moreyrajulian/arquitectura_de_computadoras/docs/spec/pipeline.md

# Arquitectura del pipeline y camino de datos

Este documento fija **qué hace cada etapa** del procesador y **qué información viaja
entre ellas**, para poder codificar `rtl/pipeline/` sin dudas sobre las interfaces.
Las instrucciones soportadas y su codificación están en [`isa.md`](isa.md).

---

## 1. Visión general

Procesador RV32I (subset de la consigna + HALT) segmentado en 5 etapas. Todo el diseño
corre en **un único dominio de reloj**: el clock nunca se detiene; parar o avanzar el
core se hace con señales de *enable* (ver `docs/diagramas/sistema.png`).

| Etapa | Qué hace | Bloques principales |
|---|---|---|
| **IF** | Mantiene el PC y lee la instrucción | registro PC, sumador `+4`, mux de próximo PC, memoria de programa |
| **ID** | Decodifica, lee registros, arma el inmediato y el control | banco de registros, generador de inmediatos, unidad de control |
| **EX** | Opera y calcula direcciones y destinos de salto | ALU, muxes de operandos, sumador de destino¹ |
| **MEM** | Lee o escribe la memoria de datos | memoria de datos, alineación y máscara de bytes |
| **WB** | Elige el valor final y lo escribe en `rd` | extensión de loads, mux de write-back |

¹ Los saltos se resuelven en EX, sin predicción (decisión [012](../decisiones/012_resolucion-saltos.md)).

```
        ┌────┐  IF/ID  ┌────┐  ID/EX  ┌────┐  EX/MEM  ┌─────┐  MEM/WB  ┌────┐
 PC ──► │ IF │ ──██──► │ ID │ ──██──► │ EX │ ──██───► │ MEM │ ──██───► │ WB │
        └────┘         └────┘         └────┘          └─────┘          └────┘
                          ▲                                               │
                          └──────────── escritura de rd ◄─────────────────┘
```

Los bloques `██` son los **registros de segmentación** (los "latches intermedios" de la
consigna): guardan todo lo que una instrucción necesita para las etapas siguientes
mientras pasa de una etapa a otra.

El camino de datos completo, con todos los bloques, campos y señales de control de este
documento, está en [`docs/diagramas/datapath.png`](../diagramas/datapath.png) (fuente
editable: `datapath.drawio`):

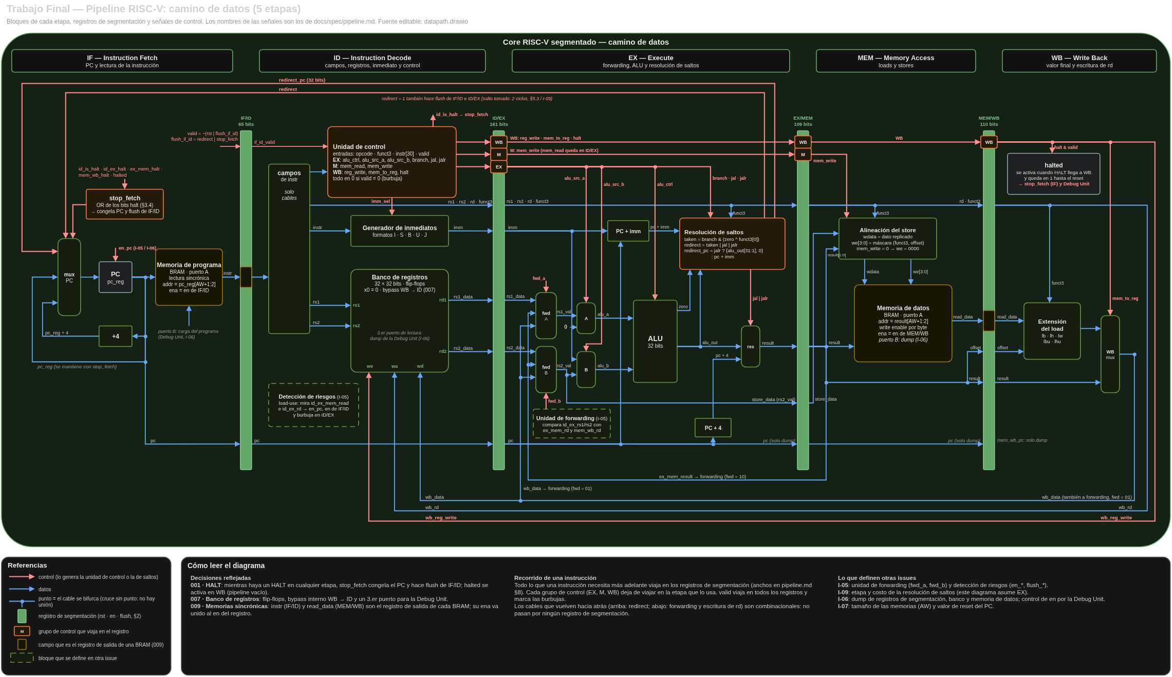
[picture p2: docs/diagramas/datapath.png]
Camino de datos del pipeline


Cómo se detectan y resuelven los riesgos de datos y de control (forwarding, stall y flush)
está en la §10, con su diagrama
[`docs/diagramas/control_riesgos.png`](../diagramas/control_riesgos.png).

---

## 2. Convenciones

### Anchos
Datos y direcciones de **32 bits**. Números de registro de 5 bits (`x0`–`x31`).

### Nombres
- Señal interna de una etapa: prefijo de la etapa (`if_`, `id_`, `ex_`, `mem_`, `wb_`).
- Campo de un registro de segmentación: prefijo del registro (`if_id_`, `id_ex_`,
  `ex_mem_`, `mem_wb_`). Ejemplo: `id_ex_rs1_data` es el valor de `rs1` que ID dejó
  guardado para EX.
- Puertos de módulo: `i_` / `o_`.

### Control de los registros de segmentación
Todos tienen las mismas tres entradas:

| Entrada | Efecto |
|---|---|
| `rst` | Carga una burbuja. |
| `en` | En 0 conserva el contenido (stall o core detenido por la Debug Unit). |
| `flush` | En 1 carga una burbuja en lugar de la instrucción entrante. |

Prioridad: `rst` > `en` > `flush`. Con `en = 0` el registro conserva su contenido aunque
`flush` valga 1: un stall o el core detenido nunca pierden la instrucción retenida.

Quién maneja `en` y `flush` está en §10.4: `en` lo bajan la detección de riesgos (stall) y la
Debug Unit (`enable`, I-06); `flush` lo generan la resolución de saltos y la detección de
riesgos, nunca la Debug Unit.

### Burbujas y bit `valid`
Cada registro de segmentación lleva un bit `valid` que indica si contiene una
instrucción real. Una **burbuja** es un registro con `valid = 0` y todas las señales de
control con efectos en 0 (escritura de registro, escritura de memoria, salto y halt); sus
campos de datos no importan.

El bit `valid` permite que el dump muestre qué etapas están vacías, que "pipeline
vacío" se pueda verificar (todos los `valid` en 0) y que se pueda anular la instrucción
de IF/ID (§3.3).

---

## 3. Etapa IF — Instruction Fetch

**Qué hace:** mantiene el PC, lee la instrucción que está en esa dirección y decide cuál
es el próximo PC.

```mermaid
flowchart LR
    MUX["mux de próximo PC"] --> PC["pc_reg"]
    PC --> SUM["+4"]
    SUM --> MUX
    SALTO["redirect / redirect_pc<br/>(etapa de salto)"] --> MUX
    PC --> IMEM["memoria de programa<br/>BRAM, puerto A"]
    IMEM -- "instr" --> IFID[["IF/ID"]]
    PC -- "pc" --> IFID
```

### 3.1 Próximo PC

```
si   redirect      →  pc_next = redirect_pc      (salto tomado: gana siempre)
sino stop_fetch    →  pc_next = pc_reg           (HALT en vuelo, §3.4)
sino               →  pc_next = pc_reg + 4
pc_reg <= pc_next     solo si en_pc = 1
```

| Señal | Ancho | Viene de | Significado |
|---|---|---|---|
| `redirect` | 1 | EX: resolución de saltos (§5.3) | Hay que cambiar el flujo: `beq`/`bne` tomado, `jal` o `jalr`. |
| `redirect_pc` | 32 | EX: resolución de saltos (§5.3) | Destino ya calculado: `PC + imm` o `(rs1 + imm) & ~1`. |
| `stop_fetch` | 1 | §3.4 | Hay un HALT en el pipeline. Congela el PC y, a través de `flush_if_id` (§3.3), invalida lo que entra a IF/ID. |
| `en_pc` | 1 | §10.4 | En 0 el PC no avanza (stall o core detenido). |

IF no necesita saber qué tipo de salto hubo: recibe la dirección ya calculada.
Valor de reset del PC: `0x0000_0000`, la primera palabra de la memoria de programa
([`memoria.md`](memoria.md) §2).

### 3.2 Memoria de programa
BRAM de lectura sincrónica: **entrega el dato un ciclo después** de recibir la dirección.
Tiene 1024 palabras (`IMEM_AW = 10`, [`memoria.md`](memoria.md)). Se direcciona con
`pc_reg[IMEM_AW+1:2]` (las instrucciones están alineadas a 4 bytes) y **su
registro de salida hace de campo `instr` de IF/ID**, así que no se agrega ningún ciclo
(decisión [009](../decisiones/009_memorias-sincronicas.md)):

```
ciclo          t            t+1           t+2
pc_reg         p            p+4           p+8
dout BRAM      (anterior)   instr(p)      instr(p+4)
if_id_pc       (anterior)   p             p+4
etapa ID       —            instr(p)      instr(p+4)
```

### 3.3 Stall, flush y reset
- **Stall:** el `ena` de la BRAM va unido al `en` de IF/ID. Con `ena = 0` la salida no
  cambia y la instrucción queda quieta.
- **Flush:** la salida de la BRAM no se puede borrar, así que el flush pone
  `if_id_valid = 0`. ID ve `valid = 0` y trata la instrucción como burbuja (§4.4).
  IF/ID tiene dos motivos de flush: un salto tomado (`redirect`) y una parada por HALT
  (`stop_fetch`, §3.4).
- **Reset:** pone `if_id_valid = 0`. La basura que tiene la BRAM a la salida después de un
  reset se ignora con el mismo mecanismo.
- **Stall y salto a la vez:** si en el mismo ciclo hay un stall (§10.3) y `redirect = 1`,
  gana el salto: el stall se anula (`en = 1`), la instrucción que quería retener está en el
  camino equivocado y se descarta con el flush, y el PC toma `redirect_pc`.

En resumen:

```
flush_if_id  = redirect | stop_fetch
if_id_valid <= ~(rst | flush_if_id)          (en cada flanco con en = 1; con en = 0 no cambia)
```

### 3.4 Parada por HALT
Mientras haya un HALT en el pipeline, IF deja de buscar instrucciones. Así detrás del HALT
solo entran burbujas, y cuando llega a WB el pipeline queda vacío
(decisión [001](../decisiones/001_instruccion-halt.md)).

```
stop_fetch  = id_is_halt | id_ex_halt | ex_mem_halt | mem_wb_halt | halted
```

`stop_fetch` actúa en dos lugares, y hacen falta los dos:

1. **PC** (§3.1): `pc_next = pc_reg`, así que no se buscan instrucciones nuevas.
2. **IF/ID** (§3.3): `flush_if_id = 1`, así que lo que entra a IF/ID es burbuja.

El primero solo no alcanza. En el ciclo en que el HALT está en ID, `pc_reg` ya vale
`h + 4` (h = dirección del HALT) y la BRAM ya está leyendo esa dirección: esa instrucción
aparece en `if_id_instr` en el flanco siguiente y no se puede cancelar. Además, con el PC
congelado, la BRAM vuelve a leer `h + 4` en cada ciclo. Sin el flush, esa instrucción
entraría como válida y se repetiría ciclo tras ciclo.

```
ciclo              t            t+1          t+2          t+3          t+4
HALT en            IF           ID           EX           MEM          WB → halted <= 1
pc_reg             h            h+4          h+4          h+4          h+4
BRAM lee           h            h+4          h+4          h+4          h+4
stop_fetch         0            1            1            1            1
IF/ID recibe       HALT (1)     h+4 (0)      h+4 (0)      h+4 (0)      h+4 (0)
```

(El número entre paréntesis es el `valid` que se guarda en IF/ID en el flanco del final
de ese ciclo.)

La parada mira el bit `halt` de todas las etapas porque el HALT está en ID un solo ciclo:
si se mirara solo ID, en t+2 el PC volvería a avanzar y entrarían instrucciones posteriores
al HALT. Al terminar t+4, `halted = 1` mantiene la parada.

- **HALT en el camino equivocado:** si un salto anterior se toma, `redirect` gana en el
  mux del PC (§3.1) y el flush convierte al HALT en burbuja. Su bit `halt` desaparece y
  `stop_fetch` se apaga solo, sin lógica extra.
- **HALT retenido por un stall:** la palabra del HALT (`0x0010_0073`) tiene `1` en el campo
  `rs2` (es el inmediato de `ebreak`), así que un load a `x1` justo antes puede disparar la
  detección de load-use (§10.3). Como `en` tiene prioridad sobre `flush` (§2), IF/ID conserva
  el HALT durante el stall y no se pierde.
- **Programa sin HALT:** `stop_fetch` no se activa nunca y el PC sigue avanzando. En la
  práctica no pasa, porque `LOAD` rellena con HALT lo que el programa no ocupa. Solo un
  programa de 1024 palabras sin HALT llega a `0x1000`, vuelve a `imem[0]` por el alias y
  levanta `imem_fault` ([`memoria.md`](memoria.md) §6.1, decisiones 001 y
  [015](../decisiones/015_accesos-desalineados-y-fuera-de-rango.md)). Un bucle infinito
  tampoco termina: para eso está `STOP` ([`protocolo_debug.md`](protocolo_debug.md) §3.5).

**En el RTL** (I-37), `stop_fetch` se calcula en `riscv_core` y entra a `pc_logic` y a
`hazard_unit`, que desde I-42 calcula los enables y el flush de §10.4. Ningún término necesita
combinarse con `valid`: `id_is_halt` sale de `id_stage` ya anulado en una burbuja (la unidad
de control da todo en 0, §4.4), y una burbuja lleva `halt = 0` en ID/EX, EX/MEM y MEM/WB (§2). Con el PC congelado, después de la parada
`pc_reg` vale `h + 4`, que es el PC que ve la Debug Unit en el bloque de estado.

### 3.5 Salidas hacia IF/ID

| Campo | Ancho | Descripción |
|---|---|---|
| `if_id_pc` | 32 | PC de la instrucción. |
| `if_id_instr` | 32 | Instrucción (salida registrada de la BRAM). |
| `if_id_valid` | 1 | 1 = instrucción real, 0 = burbuja. |

`PC + 4` no viaja: se recalcula en EX cuando hace falta (`jal`, `jalr`).

---

## 4. Etapa ID — Instruction Decode

**Qué hace:** convierte los 32 bits de la instrucción en todo lo que las etapas
siguientes necesitan para ejecutarla: los **valores** de los registros fuente, el
**inmediato** y las **señales de control**. Toda la lógica es combinacional; el resultado
se guarda en ID/EX al final del ciclo.

```mermaid
flowchart LR
    IFID[["IF/ID"]] -- "instr" --> CAMPOS["separación<br/>de campos"]
    CAMPOS -- "rs1, rs2" --> RF["banco de<br/>registros"]
    CAMPOS -- "instr" --> IMM["generador de<br/>inmediatos"]
    CAMPOS -- "opcode, funct3, bit 30" --> CTRL["unidad de<br/>control"]
    CTRL -- "imm_sel" --> IMM
    WB["WB: escritura de rd"] --> RF
    RF -- "rs1_data, rs2_data" --> IDEX[["ID/EX"]]
    IMM -- "imm" --> IDEX
    CTRL -- "señales EX, M, WB" --> IDEX
    CAMPOS -- "rs1, rs2, rd, funct3" --> IDEX
    IFID -- "pc, valid" --> IDEX
```

### 4.1 Campos de la instrucción
Cada campo ocupa siempre los mismos bits (ver [`isa.md`](isa.md)), así que se separan
con cables, sin lógica y sin saber todavía qué instrucción es.

| Campo | Bits | Para qué se usa |
|---|---|---|
| `opcode` | `[6:0]` | Unidad de control. |
| `rd` | `[11:7]` | Registro destino; viaja hasta WB. |
| `funct3` | `[14:12]` | Operación de ALU, tipo de salto, tamaño de acceso a memoria. |
| `rs1` | `[19:15]` | Primer registro fuente. |
| `rs2` | `[24:20]` | Segundo registro fuente. |
| `instr[30]` | `[30]` | Distingue `add`/`sub` y `srl`/`sra` (§4.5). |

Cuando una instrucción no usa un campo, esos bits tienen otra cosa. Por ejemplo, en
`sw` el campo `rd` son bits del inmediato. El control anula su efecto (en `sw`,
`reg_write = 0`), así que el valor de esos bits no importa.

### 4.2 Banco de registros
- 32 registros de 32 bits, implementados con flip-flops.
- `x0` vale siempre 0: leerlo devuelve 0 y escribirlo no tiene efecto.
- **Lectura:** dos puertos asíncronos (`rs1`, `rs2`); el dato está disponible en el mismo
  ciclo.
- **Escritura:** un puerto en el flanco de subida, **manejado por WB** (`wb_reg_write`,
  `wb_rd`, `wb_data`). Solo escribe con el core habilitado: `we = wb_reg_write & enable`
  (decisión [018](../decisiones/018_paso-a-paso-sin-clock.md)), para que con el core detenido
  los registros no se adelanten al pipeline.
- **Bypass:** si en el mismo ciclo WB escribe el registro que ID está leyendo, la lectura
  entrega el dato nuevo (decisión [007](../decisiones/007_banco-registros.md)):

  ```
  id_rs1_data = (rs1 == 0)                     ? 0       :
                (wb_reg_write && wb_rd == rs1) ? wb_data :
                                                 regs[rs1]
  (ídem para rs2)
  ```

  La condición usa `wb_reg_write` y no `we`: con `enable = 0` ID/EX no carga, así que el
  resultado es el mismo y `enable` queda fuera del camino de lectura.
- **Tercer puerto de lectura** para el dump de la Debug Unit (`dbg_reg_addr` /
  `dbg_reg_data`, [`protocolo_debug.md`](protocolo_debug.md) §7). Es asíncrono, lee `x0` como 0
  y entrega el valor **guardado, sin bypass**: con el core detenido, una instrucción retenida
  en MEM/WB todavía no escribió, y el dump lo muestra así (decisión
  [018](../decisiones/018_paso-a-paso-sin-clock.md)).
- **Reset:** `core_rst` pone los 32 registros en 0 y gana sobre `enable` (decisión 007). Es
  la excepción a "no resetear caminos de datos" de la decisión
  [010](../decisiones/010_convenciones-rtl.md).
- **Módulo** `rtl/common/regfile.v`: `i_rs1_addr`, `i_rs2_addr` → `o_rs1_data`, `o_rs2_data`;
  escritura `i_we` (`wb_reg_write`), `i_rd_addr` (`wb_rd`), `i_rd_data` (`wb_data`) e `i_en`
  (`enable`); debug `i_dbg_reg_addr` → `o_dbg_reg_data`. El arreglo `regs` no tiene
  `$readmemh`: el banco de pruebas lo carga por jerarquía después del reset (decisión
  [021](../decisiones/021_banco-incremental.md)).

### 4.3 Generador de inmediatos
Reconstruye el inmediato según el formato que indica `imm_sel` y lo **extiende con signo**
a 32 bits usando `instr[31]`:

| `imm_sel` | Código | Instrucciones | Inmediato de 32 bits |
|---|---|---|---|
| `I` | `000` | aritméticas con inmediato, loads, `jalr` | `{{20{i[31]}}, i[31:20]}` |
| `S` | `001` | `sb`, `sh`, `sw` | `{{20{i[31]}}, i[31:25], i[11:7]}` |
| `B` | `010` | `beq`, `bne` | `{{19{i[31]}}, i[31], i[7], i[30:25], i[11:8], 1'b0}` |
| `U` | `011` | `lui` | `{i[31:12], 12'b0}` |
| `J` | `100` | `jal` | `{{11{i[31]}}, i[31], i[19:12], i[20], i[30:21], 1'b0}` |

Los códigos son las constantes `IMM_*` de `rtl/common/riscv_defs.vh`, la interfaz entre la
unidad de control y el generador de inmediatos. Donde la tabla de verdad de §4.4 dice `x`
(tipo R, HALT, no reconocida, burbuja), `imm_sel` vale `000`; el inmediato que resulta no
se usa.

En B y J el bit 0 es siempre 0, porque los saltos van a direcciones pares. En `sltiu` el
inmediato también se extiende con signo; la comparación sin signo se hace después, en la ALU.

Un código de `imm_sel` que no corresponde a ningún formato da `imm = 0`. Las instrucciones
sin inmediato (R-type, HALT, no reconocidas) reciben el `imm_sel` que fije la tabla de §4.4,
y su `id_ex_imm` no se usa ni se compara contra el modelo.

### 4.4 Unidad de control
Mira `opcode` (y `funct3` e `instr[30]` para la ALU) y genera las señales de control.
Las señales se agrupan según la etapa que las usa. Cada grupo viaja por los registros de
segmentación hasta su etapa y ahí deja de viajar.

| Señal (nombre habitual) | Ancho | Qué indica | La usa |
|---|---|---|---|
| `imm_sel` | 3 | Formato del inmediato. | ID |
| `alu_ctrl` (ALU control) | 4 | Operación de la ALU (§4.5). | EX |
| `alu_src_a` | 1 | Operando A: 0 = `rs1`, 1 = cero (para `lui`). | EX |
| `alu_src_b` (ALUSrc) | 1 | Operando B: 0 = `rs2`, 1 = inmediato. | EX |
| `branch` (Branch) | 1 | Es `beq`/`bne` (el tipo lo da `funct3`). | etapa de salto |
| `jal` | 1 | Es `jal`. | etapa de salto |
| `jalr` | 1 | Es `jalr`. | etapa de salto |
| `mem_read` (MemRead) | 1 | Es un load. La detección de load-use (§10.3) la lee en ID/EX. | ID/EX |
| `mem_write` (MemWrite) | 1 | Escribe memoria. | MEM |
| `reg_write` (RegWrite) | 1 | Escribe `rd`. También lo usa el forwarding (§10.2). | WB |
| `mem_to_reg` (MemtoReg) | 1 | Qué se escribe en `rd`: 0 = resultado de EX, 1 = dato de memoria. | WB |
| `halt` | 1 | Es HALT. | IF y WB |

**Tabla de verdad** (`x` = no importa, se implementa como 0):

| Instrucción | Opcode | `imm_sel` | `alu_src_a` | `alu_src_b` | `alu_ctrl` | `branch` | `jal` | `jalr` | `mem_read` | `mem_write` | `reg_write` | `mem_to_reg` | `halt` |
|---|---|---|---|---|---|---|---|---|---|---|---|---|---|
| R-type | `0110011` | x | 0 | 0 | §4.5 | 0 | 0 | 0 | 0 | 0 | 1 | 0 | 0 |
| I aritmética | `0010011` | I | 0 | 1 | §4.5 | 0 | 0 | 0 | 0 | 0 | 1 | 0 | 0 |
| Load | `0000011` | I | 0 | 1 | ADD | 0 | 0 | 0 | 1 | 0 | 1 | 1 | 0 |
| Store | `0100011` | S | 0 | 1 | ADD | 0 | 0 | 0 | 0 | 1 | 0 | x | 0 |
| Branch | `1100011` | B | 0 | 0 | SUB | 1 | 0 | 0 | 0 | 0 | 0 | x | 0 |
| `jal` | `1101111` | J | x | x | x | 0 | 1 | 0 | 0 | 0 | 1 | 0 | 0 |
| `jalr` | `1100111` | I | 0 | 1 | ADD | 0 | 0 | 1 | 0 | 0 | 1 | 0 | 0 |
| `lui` | `0110111` | U | 1 | 1 | ADD | 0 | 0 | 0 | 0 | 0 | 1 | 0 | 0 |
| HALT | palabra `0x0010_0073` | x | x | x | x | 0 | 0 | 0 | 0 | 0 | 0 | x | 1 |
| No reconocida | — | x | x | x | x | 0 | 0 | 0 | 0 | 0 | 0 | x | 0 |
| Burbuja (`valid = 0`) | — | x | x | x | x | 0 | 0 | 0 | 0 | 0 | 0 | x | 0 |

- `jal` y `jalr` escriben `PC + 4` en `rd`. Ese valor sale de EX como resultado, por eso
  `mem_to_reg = 0`.
- `lui` calcula `0 + inmediato`: `alu_src_a = 1` pone un cero en el operando A.
- Una instrucción **no reconocida** (por ejemplo `0x0000_0000` o `ecall`) no tiene ningún
  efecto: se comporta como NOP.
- La unidad de control decodifica **solo por `opcode`** (y la palabra completa para HALT).
  "No reconocida" es un opcode que no está en la tabla, o uno SYSTEM distinto de HALT. Una
  palabra con opcode conocido y `funct3`/`funct7` fuera de [`isa.md`](isa.md) (por ejemplo
  `blt` o `mul`) no se anula: recibe el control de la fila de su opcode y su resultado no
  está especificado (decisión [024](../decisiones/024_instrucciones-no-soportadas.md)). El
  ensamblador y la interfaz de la PC no generan ni cargan ninguna palabra fuera de `isa.md`,
  de ninguno de los dos casos (decisión [025](../decisiones/025_filtro-de-palabras-en-el-toolchain.md)).
- `halt` solo se activa si `if_id_valid = 1`, para que la basura que queda después de un
  reset no se confunda con un HALT.

### 4.5 Control de la ALU
La operación de la ALU se decide completa en ID, dentro de la unidad de control, sin un módulo
`alu_control` aparte (decisión [026](../decisiones/026_control-de-alu-en-id.md)). A EX solo
viajan los 4 bits de `alu_ctrl`, y el código es `{instr[30], funct3}`:

| Operación | `alu_ctrl` | Instrucciones |
|---|---|---|
| ADD | `0000` | `add`, `addi`, loads, stores, `jalr`, `lui` |
| SUB | `1000` | `sub`, `beq`, `bne` |
| SLL | `0001` | `sll`, `slli` |
| SLT | `0010` | `slt`, `slti` |
| SLTU | `0011` | `sltu`, `sltiu` |
| XOR | `0100` | `xor`, `xori` |
| SRL | `0101` | `srl`, `srli` |
| SRA | `1101` | `sra`, `srai` |
| OR | `0110` | `or`, `ori` |
| AND | `0111` | `and`, `andi` |

Reglas por tipo:

```
R-type:        alu_ctrl = { instr[30], funct3 }
I aritmética:  alu_ctrl = { (funct3 == 3'b101) ? instr[30] : 1'b0, funct3 }
resto:         ADD o SUB según la tabla de verdad
```

En las I aritméticas, `instr[30]` es un bit del inmediato. Solo se usa en `srli`/`srai`
(`funct3 = 101`), donde efectivamente distingue una de la otra. Si se tomara siempre, un
`addi` con inmediato negativo se ejecutaría como resta.

### 4.6 Salidas hacia ID/EX

| Campo | Ancho | Descripción |
|---|---|---|
| `id_ex_valid` | 1 | 1 = instrucción real, 0 = burbuja. |
| `id_ex_pc` | 32 | PC de la instrucción. |
| `id_ex_rs1_data` | 32 | Valor de `rs1`. |
| `id_ex_rs2_data` | 32 | Valor de `rs2` (operando B o dato del store). |
| `id_ex_imm` | 32 | Inmediato extendido. |
| `id_ex_rs1`, `id_ex_rs2` | 5 + 5 | Números de registro fuente (forwarding, §10.2). |
| `id_ex_rd` | 5 | Registro destino. |
| `id_ex_funct3` | 3 | Tipo de salto; tamaño y signo del acceso a memoria. |
| `alu_ctrl`, `alu_src_a`, `alu_src_b` | 4 + 1 + 1 | Control de EX. |
| `branch`, `jal`, `jalr` | 3 | Control de salto. |
| `mem_read`, `mem_write` | 2 | Es un load (para riesgos) y control de MEM. |
| `reg_write`, `mem_to_reg` | 2 | Control de WB. |
| `id_ex_halt` | 1 | HALT en vuelo. |
| **Total** | **161** | |

### 4.7 Módulo `id_stage`
`rtl/pipeline/id_stage.v` es la etapa completa: `regfile`, `control_unit`, `imm_gen` e
`id_ex_reg`, con el mismo criterio que `if_stage` (decisión
[023](../decisiones/023_interfaz-debug-del-core.md)). El banco de registros va adentro porque la
dirección (`rs1`, `rs2`) y el dato leído son de ID. Si quedara en `riscv_core`, el cable saldría
de la etapa y volvería a entrar. El banco de pruebas lo encuentra en
`u_id_stage.u_regfile.regs` ([`verificacion.md`](verificacion.md) §8.5).

- **No calcula enables ni flush:** recibe `en_id_ex` y `flush_id_ex` ya calculados (§10.4), y
  además `enable` para la escritura del banco. Son señales distintas: con un stall, ID/EX carga
  una burbuja y el banco puede seguir escribiendo.
- **Escritura del banco:** entra desde WB (`wb_reg_write`, `wb_rd`, `wb_data`, §7.2), que
  arma `wb_stage` (§7.4).
- **Salidas:** los 20 campos `id_ex_*` de §8, el bus `o_id_ex_latch` para la Debug Unit, el
  puerto de lectura del banco (`dbg_reg_addr` / `dbg_reg_data`) e `id_is_halt` (el `halt` de la
  unidad de control, para `stop_fetch`, §3.4).

---

## 5. Etapa EX — Execute

**Qué hace:** ejecuta la orden que armó ID: elige los operandos, opera en la ALU,
resuelve los saltos y deja listo el resultado de la instrucción.

```mermaid
flowchart LR
    IDEX[["ID/EX"]] -- "rs1_data, rs2_data" --> FWD["muxes de<br/>forwarding"]
    ANT["EX/MEM y WB<br/>(resultados recientes)"] --> FWD
    FWD -- "rs1_val" --> MA["mux A"]
    FWD -- "rs2_val" --> MB["mux B"]
    IDEX -- "imm" --> MB
    MA --> ALU["ALU"]
    MB --> ALU
    ALU -- "alu_out" --> RES["mux de<br/>resultado"]
    IDEX -- "pc" --> P4["PC + 4"]
    P4 --> RES
    IDEX -- "pc, imm" --> TGT["PC + imm"]
    ALU -- "zero, alu_out" --> SAL["resolución<br/>de saltos"]
    TGT --> SAL
    SAL -- "redirect, redirect_pc" --> IF["IF"]
    RES -- "result" --> EXMEM[["EX/MEM"]]
    FWD -- "rs2_val" --> EXMEM
```

### 5.1 Selección de operandos
Primero, el **forwarding**: el valor de `rs1` o `rs2` que se leyó en ID puede estar viejo,
porque una instrucción anterior que todavía no llegó a WB lo está modificando. Cada
operando pasa por un mux de tres entradas:

| `fwd_a` / `fwd_b` | Valor | Cuándo se usa |
|---|---|---|
| `00` | `id_ex_rs1_data` / `id_ex_rs2_data` | Caso normal: el valor leído en ID es el correcto. |
| `10` | `ex_mem_result` | La instrucción anterior (ahora en MEM) escribe ese registro. |
| `01` | `wb_data` | La instrucción de hace dos (ahora en WB) escribe ese registro. |

Los selectores los genera la unidad de forwarding (§10.2). La codificación es la habitual
para esta unidad: `10` toma el dato de EX/MEM y `01` el de MEM/WB. Si las dos
instrucciones anteriores escriben el mismo registro, gana EX/MEM porque es el valor más
reciente. Los códigos son las constantes `FWD_*` de `rtl/common/riscv_defs.vh`.

A la salida de estos muxes están `rs1_val` y `rs2_val`, los valores **correctos** de los
registros fuente.

Después, los operandos de la ALU:

```
alu_a = alu_src_a ? 0   : rs1_val
alu_b = alu_src_b ? imm : rs2_val
```

### 5.2 ALU
ALU de 32 bits con las 10 operaciones de §4.5, seleccionadas por `alu_ctrl`.
Salidas: `alu_out` (resultado) y `zero` (1 si `alu_out == 0`). En los desplazamientos
usa solo `alu_b[4:0]`.

- Suma y resta son módulo 2^32, sin acarreo ni desborde. `slt` y `sltu` dan 1 o 0.
- Un código de `alu_ctrl` que no está en §4.5 da `alu_out = 0`. Ninguna palabra de
  [`isa.md`](isa.md) lo genera, y su resultado no está especificado (decisión
  [024](../decisiones/024_instrucciones-no-soportadas.md)).
- **Módulo** `rtl/common/alu.v`, combinacional: `i_a` (`alu_a`), `i_b` (`alu_b`) e
  `i_alu_ctrl` → `o_result` (`alu_out`) y `o_zero`. Los códigos son las constantes `ALU_*` de
  `rtl/common/riscv_defs.vh`.

### 5.3 Resolución de saltos
Hay un sumador dedicado para `PC + imm`; la ALU queda libre para comparar o calcular
`rs1 + imm`.

```
taken       = branch & (zero ^ funct3[0])        beq: salta si zero = 1
                                                 bne: salta si zero = 0
redirect    = taken | jal | jalr
redirect_pc = jalr ? {alu_out[31:1], 1'b0}       (rs1 + imm, con el bit 0 en cero)
                   : pc + imm                    (branch y jal)
```

- La ALU compara con una resta: `beq` salta si `rs1 - rs2 = 0`.
- No hay predicción: mientras el salto llega a EX, IF sigue buscando `PC + 4`.
- Cuando `redirect = 1`, IF y ID contienen instrucciones que se buscaron siguiendo
  `PC + 4` y no deben ejecutarse: se hace flush de IF/ID y de ID/EX (§10.5).
- **Penalización:** un salto tomado (`beq`/`bne` tomado, `jal`, `jalr`) pierde **2 ciclos**;
  uno no tomado, **0** (tabla completa en §10.5).
- Por qué en EX y no en ID ni con predicción: decisión [012](../decisiones/012_resolucion-saltos.md).
- **Módulo** `rtl/pipeline/branch_unit.v`, combinacional: `i_branch`, `i_jal`, `i_jalr`,
  `i_funct3`, `i_pc` e `i_imm` (de ID/EX), `i_zero` e `i_alu_out` (de la ALU, §5.2) →
  `o_redirect`, `o_redirect_pc`. No mira `valid`: una burbuja trae `branch`, `jal` y `jalr`
  en 0 (§2). La dirección de retorno (`PC + 4`) no sale de acá: es el mux de resultado
  (§5.4). Sus salidas llegan a IF desde I-36, y desde I-42 `redirect` entra también a
  `hazard_unit`, que hace el flush de IF/ID e ID/EX (§10.5).

### 5.4 Resultado
```
result = (jal | jalr) ? pc + 4 : alu_out
```
Para `jal` y `jalr`, el valor a guardar en `rd` es la dirección de retorno (`PC + 4`).
Para el resto es la salida de la ALU; en loads y stores esa salida es la dirección de
memoria.

### 5.5 Salidas hacia EX/MEM

| Campo | Ancho | Descripción |
|---|---|---|
| `ex_mem_valid` | 1 | 1 = instrucción real, 0 = burbuja. |
| `ex_mem_pc` | 32 | PC de la instrucción (identifica la etapa en el dump). |
| `ex_mem_result` | 32 | Resultado de EX; en loads y stores, la dirección. |
| `ex_mem_store_data` | 32 | Dato a guardar (`rs2_val`, ya con forwarding). |
| `ex_mem_rd` | 5 | Registro destino. |
| `ex_mem_funct3` | 3 | Tamaño y signo del acceso a memoria. |
| `mem_write` | 1 | Control de MEM. |
| `reg_write`, `mem_to_reg` | 2 | Control de WB. |
| `ex_mem_halt` | 1 | HALT en vuelo. |
| **Total** | **109** | |

> **Hipótesis de camino crítico** (decisión [012](../decisiones/012_resolucion-saltos.md), a verificar en la integración con el
> reporte de timing de Vivado). El camino más largo sería el de la decisión de salto, que
> termina en `pc_reg`:
>
> ```
> BRAM de datos (load en WB) → extensión del load → mux de WB → mux de forwarding (01)
>   → ALU (resta) → zero → taken → redirect → mux de próximo PC → pc_reg
> ```
>
> `redirect` además maneja el flush de IF/ID e ID/EX; para acotar su fanout, el flush solo
> pone en 0 `valid` y los campos de control (los datos de una burbuja no importan, §2). Si el
> reporte confirma que este camino limita la frecuencia, las medidas en orden de costo son:
> comparar con un comparador de igualdad en lugar de la resta y `zero` (solo hay `beq` y
> `bne`), registrar `redirect` y aplicarlo desde MEM (3 ciclos de penalización), o bajar la
> frecuencia.

### 5.6 Módulo `ex_stage`
`rtl/pipeline/ex_stage.v` es la etapa completa: los muxes de forwarding y de operandos (§5.1),
`alu` (§5.2), `branch_unit` (§5.3), el mux de resultado (§5.4) y `ex_mem_reg`, con el mismo
criterio que `id_stage` (§4.7, decisión [023](../decisiones/023_interfaz-debug-del-core.md)).
Los muxes de forwarding van adentro porque §5.1 los pone en EX y su entrada `10` es la salida
del propio EX/MEM; la unidad que elige el selector (§10.2, I-39) queda afuera.

- **No calcula enables, flush ni forwarding:** recibe `en_ex_mem` y `flush_ex_mem` ya
  calculados (§10.4), `fwd_a` / `fwd_b` y `wb_data` (§7.2). Los selectores vienen de
  `forwarding_unit` (§10.2, desde I-39); `wb_data` viene de `wb_stage` (§7.4). El código `11`
  no lo genera la unidad de forwarding; si llega, toma lo leído en ID, como `00`.
- **De ID/EX** entran los campos que usa EX y los que pasan a EX/MEM. `rs1`, `rs2` y
  `mem_read` no entran: los usan la unidad de forwarding (§10.2) y la detección de load-use
  (§10.3).
- **Salidas:** los 10 campos `ex_mem_*` de §8, el bus `o_ex_mem_latch` para la Debug Unit y
  `redirect` / `redirect_pc` de `branch_unit` hacia IF. Desde I-36 `riscv_core` los conecta al
  mux de próximo PC (§3.1), y desde I-42 `redirect` entra también a `hazard_unit`, que hace el
  flush de IF/ID y de ID/EX (§10.4, §10.5).

---

## 6. Etapa MEM — Memory Access

**Qué hace:** en un store escribe la memoria de datos; en un load entrega la dirección
para que el dato llegue en el ciclo siguiente. El resto de las instrucciones atraviesan
MEM sin hacer nada.

```mermaid
flowchart LR
    EXMEM[["EX/MEM"]] -- "result = dirección" --> DMEM["memoria de datos<br/>BRAM, puerto A"]
    EXMEM -- "store_data, funct3" --> ALIN["alineación y<br/>máscara de bytes"]
    ALIN -- "wdata, we[3:0]" --> DMEM
    DMEM -- "dato leído (llega en WB)" --> MEMWB[["MEM/WB"]]
    EXMEM -- "result, rd, funct3, control" --> MEMWB
```

### 6.1 Dirección
La memoria está organizada en palabras de 32 bits, pero se direcciona por byte:

```
índice de palabra = result[DMEM_AW+1:2]          (DMEM_AW = 10: 1024 palabras)
byte dentro de la palabra (offset) = result[1:0]
```

Los bits `result[31:DMEM_AW+2]` no llegan a la memoria (§6.4). Mapa de direcciones y
configuración de la BRAM: [`memoria.md`](memoria.md).

### 6.2 Escritura (stores)
Un store puede escribir 1, 2 o 4 bytes de la palabra. La BRAM tiene un *write enable*
por byte (`we[3:0]`): solo se escriben los bytes con su bit en 1.

| Instrucción | `funct3` | `wdata` | `we[3:0]` |
|---|---|---|---|
| `sb` | `000` | `{4{d[7:0]}}` | `0001 << offset` |
| `sh` | `001` | `{2{d[15:0]}}` | `0011 << {offset[1], 0}` |
| `sw` | `010` | `d` | `1111` |

`d` es `ex_mem_store_data`. El dato se **repite** en todas las posiciones de la palabra y la
máscara elige cuál se escribe. Así no hace falta un desplazador. Ejemplo: `sb` en una
dirección con `offset = 2` pone el byte en los cuatro lugares y escribe solo con
`we = 0100`, es decir, en los bits `[23:16]`. Si `mem_write = 0`, `we = 0000`.

### 6.3 Lectura (loads)
La BRAM se lee siempre con la dirección de `ex_mem_result`, y la palabra completa aparece
**en el ciclo siguiente**: su registro de salida hace de campo `mem_wb_read_data`
(decisión [009](../decisiones/009_memorias-sincronicas.md)). Seleccionar el byte o la
media palabra y extenderla se hace en WB (§7.1). El `ena` de la BRAM va unido al `en`
de MEM/WB, para que con el core detenido el dato leído no cambie.

### 6.4 Accesos desalineados y fuera de rango
No generan excepciones: el hardware ignora los bits que no corresponden
(decisión [015](../decisiones/015_accesos-desalineados-y-fuera-de-rango.md)).

- **Desalineados:** un `lw` o `sw` ignora `offset` y un `lh`/`lhu`/`sh` ignora `offset[0]`.
  El acceso cae en la palabra o media palabra alineada que lo contiene.
- **Fuera de rango** (`result ≥ 0x1000`): los bits `[31:12]` se ignoran y el acceso cae en
  `result mod 4096`.

Cada caso pone en 1 un aviso persistente (`dmem_misaligned`, `dmem_oob`) que se calcula en MEM
con `ex_mem_result`, `ex_mem_funct3`, `mem_write` y `mem_to_reg`, y que la Debug Unit informa
en el bloque de estado ([`memoria.md`](memoria.md) §6.2). Nada del camino de datos lee esos
avisos.

### 6.5 Salidas hacia MEM/WB

| Campo | Ancho | Descripción |
|---|---|---|
| `mem_wb_valid` | 1 | 1 = instrucción real, 0 = burbuja. |
| `mem_wb_pc` | 32 | PC de la instrucción (identifica la etapa en el dump). |
| `mem_wb_result` | 32 | Resultado de EX (para todo lo que no es load). |
| `mem_wb_read_data` | 32 | Palabra leída. Es la salida registrada de la BRAM, no un flip-flop aparte. |
| `mem_wb_rd` | 5 | Registro destino. |
| `mem_wb_funct3` | 3 | Tamaño y signo del load. |
| `mem_wb_offset` | 2 | Byte dentro de la palabra (`result[1:0]`). |
| `reg_write`, `mem_to_reg` | 2 | Control de WB. |
| `mem_wb_halt` | 1 | HALT en vuelo. |
| **Total** | **110** | (78 en flip-flops + 32 de la BRAM) |

### 6.6 Módulo `dmem`
`rtl/memory/dmem.v` reúne la BRAM, la máscara y la replicación de §6.2 y los avisos de §6.4
(decisión [027](../decisiones/027_logica-de-mem-en-dmem.md)). Recibe los campos de EX/MEM y
entrega la palabra completa como `mem_wb_read_data`; la extensión es de WB (§7.1). Sus puertos
están en [`memoria.md`](memoria.md) §3.3.

### 6.7 Módulo `mem_stage`
`rtl/pipeline/mem_stage.v` es la etapa completa: `dmem` (§6.6) y `mem_wb_reg`, con el mismo
criterio que `id_stage` y `ex_stage` (§4.7, §5.6, decisión
[023](../decisiones/023_interfaz-debug-del-core.md)). La BRAM va adentro porque su registro de
salida es el campo `mem_wb_read_data` (§6.3), como `imem` dentro de `if_stage`.

- **No calcula enables ni flush:** recibe `en_mem_wb` y `flush_mem_wb` ya calculados (§10.4).
  `en_mem_wb` es a la vez el `en` de MEM/WB y el `ena` del puerto A de `dmem`, así que con el
  core detenido los 110 bits de MEM/WB quedan quietos, `read_data` incluido.
- **`offset`** es `ex_mem_result[1:0]` (§6.1); lo arma la etapa y `mem_wb_reg` solo lo copia.
- **Salidas:** los 10 campos `mem_wb_*` de §8, el bus `o_mem_wb_latch` para la Debug Unit, el
  puerto B de `dmem` (`dmem_b_*`, [`memoria.md`](memoria.md) §3.3) y los avisos `dmem_oob` y
  `dmem_misaligned`, que `riscv_core` saca como puertos junto con `imem_fault` (§7.4).

---

## 7. Etapa WB — Write Back

**Qué hace:** arma el valor final de la instrucción y lo escribe en `rd`. Ese mismo valor
se reenvía a EX (forwarding).

```mermaid
flowchart LR
    MEMWB[["MEM/WB"]] -- "read_data, funct3, offset" --> EXT["extensión<br/>del load"]
    EXT --> MUX["mux de<br/>write-back"]
    MEMWB -- "result" --> MUX
    MUX -- "wb_data" --> RF["banco de registros (ID)"]
    MUX -- "wb_data" --> FWD["forwarding (EX)"]
    MEMWB -- "halt, valid" --> H["registro halted"]
```

### 7.1 Extensión del load
Del dato leído se toma la parte que corresponde y se extiende a 32 bits:

```
byte = read_data >> (8 * offset)       [7:0]
half = read_data >> (16 * offset[1])   [15:0]
```

| Instrucción | `funct3` | Valor |
|---|---|---|
| `lb` | `000` | `byte` extendido con signo |
| `lh` | `001` | `half` extendido con signo |
| `lw` | `010` | `read_data` |
| `lbu` | `100` | `byte` extendido con ceros |
| `lhu` | `101` | `half` extendido con ceros |

### 7.2 Valor final y escritura

```
wb_data      = mem_to_reg ? valor_del_load : mem_wb_result
wb_reg_write = mem_wb_reg_write
wb_rd        = mem_wb_rd
```

Estas tres señales van al puerto de escritura del banco de registros, en ID (§4.2).
`wb_data` también es la entrada `01` de los muxes de forwarding de EX (§5.1).

### 7.3 Registro `halted`
Cuando un HALT llega a WB, ya no puede ser anulado por ningún salto. En ese momento se
activa `halted`, que queda en 1 hasta el próximo reset (decisión 001):

```
si (enable & mem_wb_valid & mem_wb_halt)  →  halted <= 1
```

Como todo elemento con estado del core, `halted` solo cambia con `enable = 1` (§10.4).

Detrás del HALT solo entraron burbujas (§3.4), así que un ciclo después todos los
`valid` están en 0: el pipeline está vacío. `halted` es la señal que la Debug Unit mira
para saber que terminó la ejecución (I-06).

### 7.4 Módulo `wb_stage`
`rtl/pipeline/wb_stage.v` es la etapa completa: la extensión del load (§7.1), el mux de
write-back (§7.2), el registro `halted` (§7.3) y el aviso `imem_fault`
([`memoria.md`](memoria.md) §6.2). Recibe los campos de MEM/WB y no tiene registro de
segmentación propio: lo que arma va al banco de registros y a EX en el mismo ciclo.

- **Salidas combinacionales:** `wb_reg_write`, `wb_rd` y `wb_data`, sin pasar por ningún
  flip-flop. `wb_reg_write` no se combina con `mem_wb_valid`: una burbuja ya trae
  `reg_write = 0` (§2). La escritura respeta `enable` dentro del banco (§4.2), no acá.
- **`funct3` fuera de la tabla de §7.1:** entrega `read_data`, como `lw`. No llega nunca,
  porque la unidad de control convierte esos loads en NOP (decisión
  [024](../decisiones/024_instrucciones-no-soportadas.md)).
- **No calcula enables ni flush:** recibe `enable` solo para sus dos flip-flops, `halted` e
  `imem_fault`, que cambian únicamente con `enable = 1`. `core_rst` los pone en 0 y gana sobre
  `enable`.
- **`imem_fault`** se levanta con una instrucción válida cuyo `mem_wb_pc` tiene bits en
  `[31:IMEM_AW+2]` o en `[1:0]`. Una búsqueda en el camino equivocado se anula antes de WB y
  no lo levanta.
- **Salidas hacia el core:** `wb_reg_write`, `wb_rd`, `wb_data`, `halted` e `imem_fault`.
  `riscv_core` saca `o_halted`, `o_imem_fault`, `o_dmem_oob` y `o_dmem_misaligned` para la
  Debug Unit (decisión [023](../decisiones/023_interfaz-debug-del-core.md)).

## 8. Registros de segmentación

Contenido completo de los cuatro registros. **Lo produce** es el bloque que calcula el
valor; **Lo usa** es quién lo lee desde ese registro. Los campos que dicen "pasa" no se
usan en la etapa siguiente: solo se copian al próximo registro.

Todos los registros tienen las entradas `rst`, `en` y `flush` de §2.

En el RTL cada campo lleva el prefijo de su registro, también las señales de control: la
columna `alu_ctrl` de ID/EX es `id_ex_alu_ctrl`, y `reg_write` de EX/MEM es `ex_mem_reg_write`
(decisión [010](../decisiones/010_convenciones-rtl.md)). Con ese nombre los lee el banco de
pruebas incremental ([`verificacion.md`](verificacion.md) §8.5). El orden de las filas de
cada tabla es el del empaquetado de la traza del modelo de referencia, el primero en los bits
más altos (decisión [020](../decisiones/020_modelo-de-referencia.md)): **cambiar un campo o
su orden cambia `tools/isasim/isasim/latches.py` y `tb/integration/pipeline_tb.v`.**

### IF/ID — 65 bits

| Campo | Ancho | Lo produce | Lo usa |
|---|---|---|---|
| `if_id_valid` | 1 | IF | ID (anula el control si vale 0) |
| `if_id_pc` | 32 | IF: `pc_reg` | pasa |
| `if_id_instr` | 32 | IF: memoria de programa (salida registrada de la BRAM) | ID: campos, generador de inmediatos, control |

### ID/EX — 161 bits

| Campo | Ancho | Lo produce | Lo usa |
|---|---|---|---|
| `id_ex_valid` | 1 | ID (copia de `if_id_valid`) | pasa |
| `id_ex_pc` | 32 | IF (pasa por ID) | EX: `PC + imm`, `PC + 4` |
| `id_ex_rs1_data` | 32 | ID: banco de registros | EX: mux de forwarding A |
| `id_ex_rs2_data` | 32 | ID: banco de registros | EX: mux de forwarding B |
| `id_ex_imm` | 32 | ID: generador de inmediatos | EX: mux B, `PC + imm` |
| `id_ex_rs1` | 5 | ID: campo `rs1` | unidad de forwarding (§10.2) |
| `id_ex_rs2` | 5 | ID: campo `rs2` | unidad de forwarding (§10.2) |
| `id_ex_rd` | 5 | ID: campo `rd` | detección de load-use (§10.3); pasa |
| `id_ex_funct3` | 3 | ID: campo `funct3` | EX: tipo de salto; pasa |
| `alu_ctrl` | 4 | ID: control | EX: ALU |
| `alu_src_a` | 1 | ID: control | EX: mux A |
| `alu_src_b` | 1 | ID: control | EX: mux B |
| `branch` | 1 | ID: control | EX: resolución de saltos |
| `jal` | 1 | ID: control | EX: resolución de saltos, mux de resultado |
| `jalr` | 1 | ID: control | EX: resolución de saltos, mux de resultado |
| `mem_read` | 1 | ID: control | detección de load-use (§10.3) |
| `mem_write` | 1 | ID: control | pasa |
| `reg_write` | 1 | ID: control | pasa |
| `mem_to_reg` | 1 | ID: control | pasa |
| `id_ex_halt` | 1 | ID: control | IF (`stop_fetch`); pasa |

### EX/MEM — 109 bits

| Campo | Ancho | Lo produce | Lo usa |
|---|---|---|---|
| `ex_mem_valid` | 1 | EX (copia) | pasa |
| `ex_mem_pc` | 32 | IF (pasa) | solo dump |
| `ex_mem_result` | 32 | EX: mux de resultado | MEM: dirección; forwarding (entrada `10`); pasa |
| `ex_mem_store_data` | 32 | EX: mux de forwarding B | MEM: dato a escribir |
| `ex_mem_rd` | 5 | ID (pasa) | unidad de forwarding (§10.2); pasa |
| `ex_mem_funct3` | 3 | ID (pasa) | MEM: tamaño del store; pasa |
| `mem_write` | 1 | ID (pasa) | MEM: `we` |
| `reg_write` | 1 | ID (pasa) | unidad de forwarding (§10.2); pasa |
| `mem_to_reg` | 1 | ID (pasa) | pasa |
| `ex_mem_halt` | 1 | ID (pasa) | IF (`stop_fetch`); pasa |

### MEM/WB — 110 bits

| Campo | Ancho | Lo produce | Lo usa |
|---|---|---|---|
| `mem_wb_valid` | 1 | MEM (copia) | WB: `halted` |
| `mem_wb_pc` | 32 | IF (pasa) | solo dump |
| `mem_wb_result` | 32 | EX (pasa) | WB: mux de write-back |
| `mem_wb_read_data` | 32 | MEM: memoria de datos (salida registrada de la BRAM) | WB: extensión del load |
| `mem_wb_rd` | 5 | ID (pasa) | WB: dirección de escritura; forwarding (§10.2) |
| `mem_wb_funct3` | 3 | ID (pasa) | WB: extensión del load |
| `mem_wb_offset` | 2 | MEM: `result[1:0]` | WB: extensión del load |
| `reg_write` | 1 | ID (pasa) | WB: habilita la escritura; forwarding (§10.2) |
| `mem_to_reg` | 1 | ID (pasa) | WB: mux de write-back |
| `mem_wb_halt` | 1 | ID (pasa) | IF (`stop_fetch`); WB: `halted` |

### Resumen

| Registro | Bits | En flip-flops | En la BRAM |
|---|---|---|---|
| IF/ID | 65 | 33 | 32 (`instr`) |
| ID/EX | 161 | 161 | — |
| EX/MEM | 109 | 109 | — |
| MEM/WB | 110 | 78 | 32 (`read_data`) |
| **Total** | **445** | **381** | **64** |

Es el contenido de los "latches intermedios" que la Debug Unit tiene que enviar a la PC
(≈ 56 bytes empaquetado). El formato lo define I-06.

## 9. Señales de control

### 9.1 Recorrido
Todas las señales de control nacen en la unidad de control de ID (§4.4), viajan por los
registros de segmentación hasta la etapa que las usa, y ahí dejan de viajar:

| Señal | ID/EX | EX/MEM | MEM/WB | Se consume en |
|---|:---:|:---:|:---:|---|
| `imm_sel` | | | | ID: generador de inmediatos (no viaja) |
| `alu_ctrl` | ● | | | EX: ALU |
| `alu_src_a`, `alu_src_b` | ● | | | EX: muxes de operandos |
| `branch`, `jal`, `jalr` | ● | | | EX: resolución de saltos (`jal`/`jalr` también en el mux de resultado) |
| `mem_read` | ● | | | ID: detección de load-use, leyendo ID/EX |
| `mem_write` | ● | ● | | MEM: `we` de la memoria de datos |
| `reg_write` | ● | ● | ● | WB: escritura del banco; forwarding lee sus copias en EX/MEM y MEM/WB |
| `mem_to_reg` | ● | ● | ● | WB: mux de write-back |
| `halt` | ● | ● | ● | IF: `stop_fetch` (todas las copias); WB: `halted` |
| `funct3`* | ● | ● | ● | EX: tipo de salto; MEM: tamaño del store; WB: tamaño y signo del load |
| `valid`* | ● | ● | ● | todas las etapas (burbujas y dump) |

\* No salen de la unidad de control: `funct3` es un campo de la instrucción y `valid`
nace en IF. Se incluyen porque viajan y actúan como control.

### 9.2 Señales de control del pipeline
Además de las que genera ID, hay señales que controlan el pipeline en sí. No viajan en
los registros de segmentación: se calculan en el ciclo y actúan en el ciclo.

| Señal | Ancho | Se genera | Se consume | Definida en |
|---|---|---|---|---|
| `redirect`, `redirect_pc` | 1 + 32 | EX: resolución de saltos | IF: mux de próximo PC | §5.3 / decisión 012 |
| `stop_fetch` | 1 | OR de los bits `halt` y `halted` | IF: mux de próximo PC y `flush_if_id` | §3.4 |
| `fwd_a`, `fwd_b` | 2 + 2 | unidad de forwarding | EX: muxes de forwarding | §10.2 |
| `en_pc`, `en_*` | 1 c/u | detección de riesgos y Debug Unit | IF y cada registro de segmentación | §10.4 / I-06 |
| `flush_*` | 1 c/u | `flush_if_id = redirect \| stop_fetch`; `flush_id_ex = redirect \| stall` | IF/ID e ID/EX | §3.3 / §10.4 / §10.5 |
| `halted` | 1 | WB (registro) | IF (`stop_fetch`) y Debug Unit | §7.3 / I-06 |
| `imem_fault`, `dmem_oob`, `dmem_misaligned` | 1 c/u | MEM y WB (registros persistentes) | Debug Unit (bloque de estado) | §6.4 / [`memoria.md`](memoria.md) §6.2 |

---

## 10. Riesgos y su control

Esta sección fija **dónde se detecta** cada riesgo y **cómo se resuelve**. El diagrama
muestra la unidad de control, la unidad de forwarding y la unidad de detección de riesgos
sobre el pipeline, con los recursos compartidos
([`docs/diagramas/control_riesgos.png`](../diagramas/control_riesgos.png), fuente
editable: `control_riesgos.drawio`):

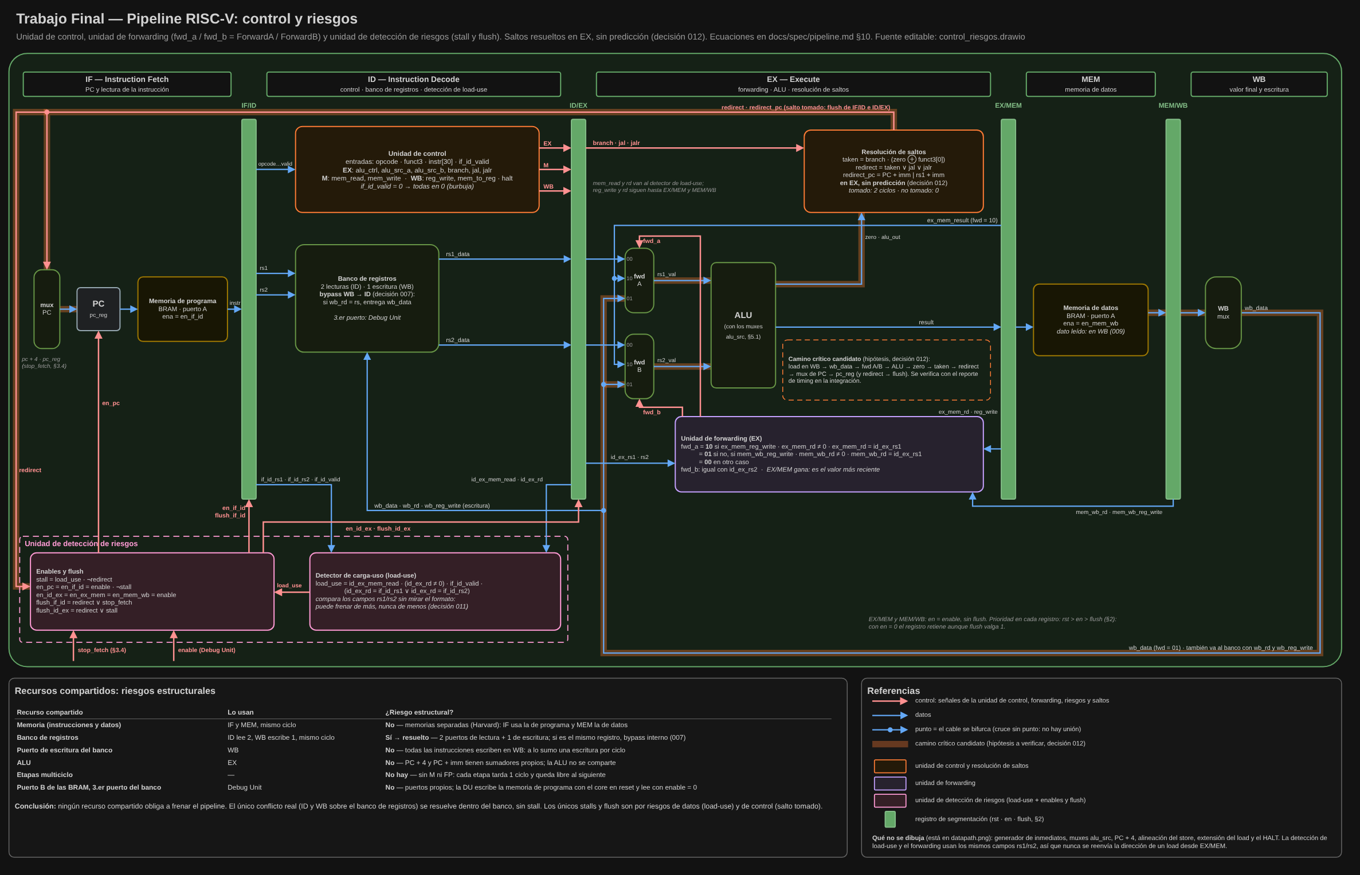
[picture p3: docs/diagramas/control_riesgos.png]
Control y riesgos


### 10.1 Resumen

| Riesgo | Ejemplo | Se detecta en | Se resuelve con | Costo |
|---|---|---|---|---|
| Datos, distancia 1 o 2 | `add x1,…` y enseguida `sub …, x1, …` | EX (unidad de forwarding) | forwarding desde EX/MEM o MEM/WB (§10.2) | 0 |
| Datos, distancia 3 | `add x1,…` y tres después `or …, x1, …` | ID (banco de registros) | bypass interno del banco ([007](../decisiones/007_banco-registros.md)) | 0 |
| Datos, carga-uso | `lw x1,…` y enseguida `add …, x1, …` | ID (detector de load-use) | 1 stall + forwarding desde MEM/WB (§10.3) | 1 ciclo |
| Control | `beq`/`bne` tomado, `jal`, `jalr` | EX (resolución de saltos) | flush de IF/ID e ID/EX (§10.5) | 2 ciclos (no tomado: 0) |
| Estructural | — | — | no hay ninguno que obligue a frenar (§10.6) | 0 |

Las dependencias WAR y WAW no son riesgos en este pipeline: las instrucciones avanzan en
orden, leen sus registros en ID (o los reciben por forwarding en EX) y escriben solo en WB.
Tampoco hay riesgos a través de la memoria de datos: un `sw` seguido de un `lw` a la misma
dirección acceden en MEM en el orden del programa.

### 10.2 Unidad de forwarding (EX)

Combinacional. Genera los selectores de los muxes de §5.1 (`fwd_a`/`fwd_b`, los
*ForwardA*/*ForwardB* del libro):

```
fwd_a = (ex_mem_reg_write && ex_mem_rd != 0 && ex_mem_rd == id_ex_rs1) ? 2'b10 :
        (mem_wb_reg_write && mem_wb_rd != 0 && mem_wb_rd == id_ex_rs1) ? 2'b01 :
                                                                         2'b00
fwd_b = ídem con id_ex_rs2
```

| Condición | Selector | Valor que entra a EX |
|---|---|---|
| La instrucción anterior (en MEM) escribe ese registro | `10` | `ex_mem_result` |
| Si no, la de hace dos (en WB) escribe ese registro | `01` | `wb_data` |
| Ninguna de las dos | `00` | lo leído en ID (`id_ex_rs1_data` / `id_ex_rs2_data`) |

- **Prioridad de EX/MEM:** si las dos instrucciones anteriores escriben el mismo registro,
  el valor más reciente es el de EX/MEM.
- **`rd ≠ 0`:** `x0` nunca se reenvía; una instrucción que "escribe" `x0` no tiene efecto.
- **Burbujas:** tienen `reg_write = 0`, así que nunca se reenvían. No hace falta mirar `valid`.
- **Saltos y stores:** `beq`/`bne` comparan `rs1_val` y `rs2_val`, ya con forwarding, así que
  un salto que depende de una instrucción aritmética anterior no pierde ciclos. El dato de un
  store (`ex_mem_store_data`) también sale de `rs2_val`.
- **`jal`/`jalr`:** su resultado (`PC + 4`) está en `ex_mem_result` y en `wb_data` como el de
  cualquier otra instrucción, así que se reenvía igual.
- **Campos sin usar:** la unidad compara `rs1` y `rs2` aunque la instrucción no los use
  (por ejemplo `rs2` de un `addi`). Si coincide, el valor reenviado entra a un operando que
  el control descarta (`alu_src_b = 1` toma el inmediato), así que no tiene efecto.
- **Nunca reenvía la dirección de un load:** cuando un load está en EX/MEM, `ex_mem_result`
  es la dirección y no el dato. Eso no llega a pasar porque la detección de load-use (§10.3)
  compara **los mismos campos** `rs1`/`rs2`: si la instrucción siguiente los usara, ya estaría
  frenada en ID. Si alguna vez se filtran los campos según el formato, hay que filtrarlos
  igual en las dos unidades.

**Módulo.** `rtl/control/forwarding_unit.v`, combinacional y sin estado (no recibe `enable`).
Entradas: `i_id_ex_rs1`, `i_id_ex_rs2`, `i_ex_mem_rd`, `i_ex_mem_reg_write`, `i_mem_wb_rd`,
`i_mem_wb_reg_write`. Salidas: `o_fwd_a`, `o_fwd_b`, con los códigos `FWD_*` de
`riscv_defs.vh`. `riscv_core` la instancia y conecta los selectores a `ex_stage` (§5.6).

Ejemplo con las tres distancias ([`riesgo_forwarding.png`](../diagramas/riesgo_forwarding.png)):

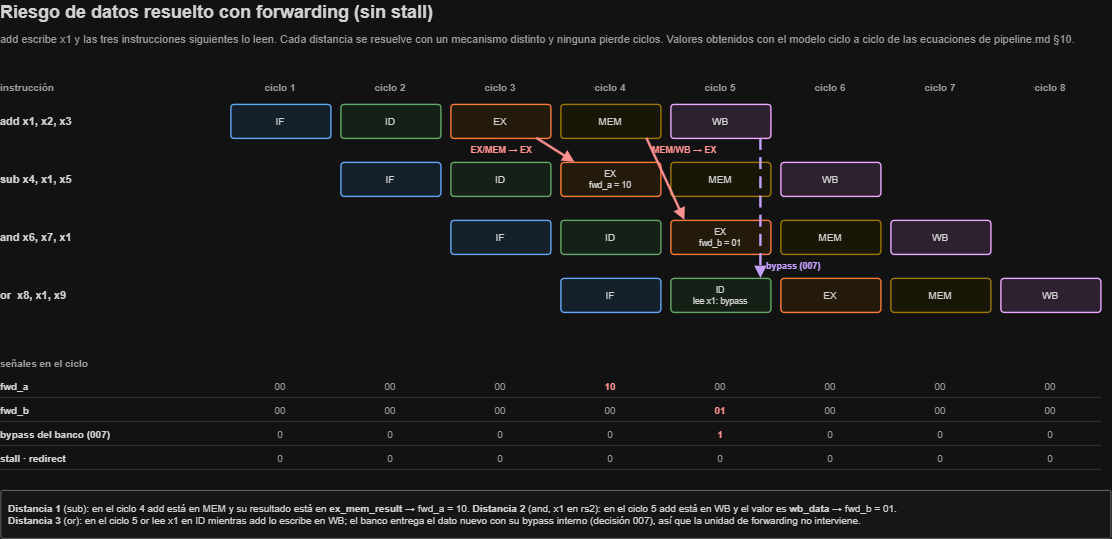
[picture p4: docs/diagramas/riesgo_forwarding.png]
Riesgo de datos resuelto con forwarding


### 10.3 Detección de carga-uso (ID)

El dato de un load aparece recién en WB (sale de la BRAM, decisión
[009](../decisiones/009_memorias-sincronicas.md)). Si la instrucción siguiente lo necesita
en EX, ese dato todavía no existe en ningún lado: hay que frenarla un ciclo. La detección se
hace en ID, mirando la instrucción que está en EX:

```
load_use = id_ex_mem_read && id_ex_rd != 0 && if_id_valid &&
           (id_ex_rd == if_id_rs1 || id_ex_rd == if_id_rs2)
```

`if_id_rs1` e `if_id_rs2` son los bits `[19:15]` y `[24:20]` de `if_id_instr`, sin decodificar.

- La comparación es **conservadora**: no mira si la instrucción en ID usa de verdad `rs1` o
  `rs2`. Puede frenar de más (`lui`, `jal` o el HALT de §3.4, cuyos bits en esas posiciones
  son parte del inmediato), nunca de menos. Cada falso positivo cuesta un ciclo y no cambia
  el resultado. Un `sw` que guarda el dato recién cargado también se frena, aunque se podría
  resolver con forwarding hacia MEM; no se implementa. Ver decisión
  [011](../decisiones/011_deteccion-load-use.md).
- Con `if_id_valid = 0` no hay nada que frenar: la burbuja no lee registros.
- Después del stall, el load está en WB y la instrucción frenada en EX: el dato llega por
  `fwd = 01` (`wb_data`). Un load seguido de un salto que usa el dato funciona igual.

**Módulo.** `rtl/control/hazard_unit.v`, combinacional y sin estado. Para la carga-uso, sus
entradas son `i_if_id_valid`, `i_if_id_rs1`, `i_if_id_rs2`, `i_id_ex_mem_read` e `i_id_ex_rd`,
y su salida `o_load_use`. Recibe los campos y no la palabra, igual que `forwarding_unit`
(§10.2), y así su testbench puede recorrer todas las combinaciones (`verificacion.md` §6).
`riscv_core` saca `if_id_rs1` e `if_id_rs2` de `if_id_instr`, con los mismos bits que usa
`id_stage`. Desde I-42 la unidad calcula además el stall y los enables y flush de §10.4 (el
párrafo **Módulo** de §10.4); en I-41 esa parte estaba en `riscv_core` (decisión
[023](../decisiones/023_interfaz-debug-del-core.md), `verificacion.md` §3.2).

Ejemplo ([`riesgo_carga_uso.png`](../diagramas/riesgo_carga_uso.png)):

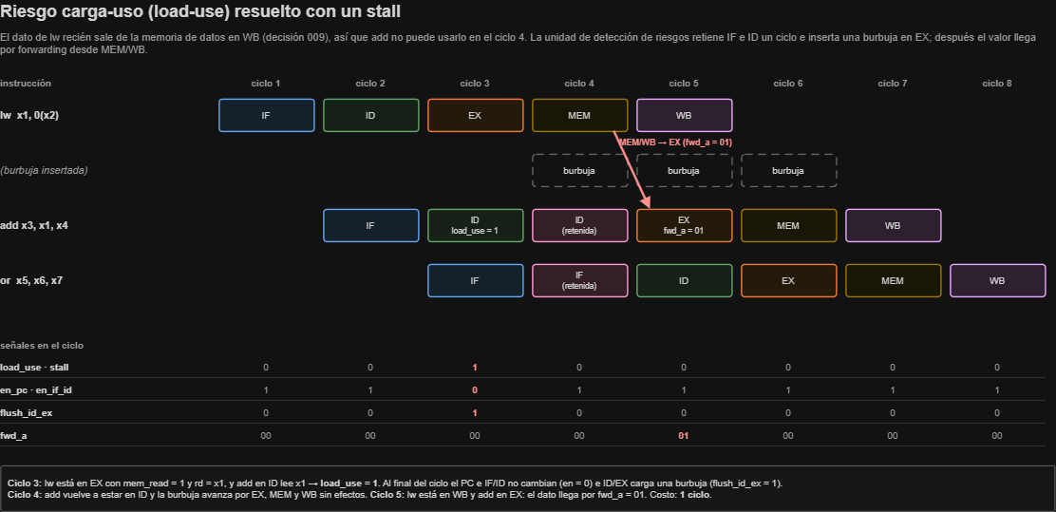
[picture p5: docs/diagramas/riesgo_carga_uso.png]
Riesgo carga-uso resuelto con un stall


### 10.4 Enables y flush

La unidad de detección de riesgos combina el detector de load-use, la resolución de saltos,
la parada por HALT y el `enable` de la Debug Unit en las entradas `en` y `flush` de cada
registro (§2):

```
stall        = load_use & ~redirect
en_pc        = enable & ~stall
en_if_id     = enable & ~stall          (también es el ena de la memoria de programa)
en_id_ex     = enable
en_ex_mem    = enable
en_mem_wb    = enable                   (también es el ena de la memoria de datos)
flush_if_id  = redirect | stop_fetch
flush_id_ex  = redirect | stall
flush_ex_mem = flush_mem_wb = 0
```

| Situación | PC | IF/ID | ID/EX | EX/MEM y MEM/WB |
|---|---|---|---|---|
| Normal | avanza | carga | carga | cargan |
| Stall por load-use | retiene | retiene | burbuja | cargan |
| Salto tomado | toma `redirect_pc` | burbuja (`valid = 0`) | burbuja | cargan |
| HALT en vuelo (§3.4) | retiene (`pc_next = pc_reg`) | burbuja | carga | cargan |
| Core detenido (`enable = 0`) | retiene | retiene | retiene | retienen |

- **Una burbuja hacia adelante:** el stall frena IF e ID y deja avanzar al resto. La burbuja
  que entra a ID/EX es la que ocupa el lugar de la instrucción retenida.
- **Stall y salto a la vez** (§3.3): gana el salto (`~redirect`). Con los saltos resueltos en
  EX (decisión [012](../decisiones/012_resolucion-saltos.md)) no puede ocurrir: la instrucción en EX es un load o un salto, no las
  dos cosas. El término queda como protección, para que la regla de §3.3 siga valiendo si
  alguna vez se agrega una redirección desde otra etapa.
- **Stall con un HALT en ID:** `flush_if_id = 1` por `stop_fetch`, pero `en_if_id = 0`; como
  `en` tiene prioridad sobre `flush`, IF/ID conserva el HALT (§3.4).
- **Core detenido en medio de un stall:** con `enable = 0` nada cambia, y al volver a 1 las
  señales combinacionales se recalculan igual. El stall continúa donde quedó, así que se puede
  avanzar ciclo a ciclo con `STEP` sin perder instrucciones.

**Módulo** (I-42). `hazard_unit` (§10.3) calcula estas ecuaciones. Además de las entradas de la
carga-uso recibe `i_enable`, `i_redirect` (de `ex_stage`, §5.3) e `i_stop_fetch` (§3.4, que
sigue calculando `riscv_core`). Salidas: `o_stall`, `o_en_pc`, `o_en_if_id`, `o_en_id_ex`,
`o_en_ex_mem`, `o_en_mem_wb`, `o_flush_if_id`, `o_flush_id_ex`, `o_flush_ex_mem` y
`o_flush_mem_wb` (estas dos, siempre 0). `riscv_core` las conecta sin lógica en el medio a
`if_stage`, `id_stage`, `ex_stage` y `mem_stage`. `enable` le llega como un dato más: la unidad
no tiene estado, así que no hay nada que congelar.

**Elementos con estado que respetan `enable`** (decisión
[018](../decisiones/018_paso-a-paso-sin-clock.md)). El clock nunca se toca: parar o avanzar el
core es dejar pasar o no el flanco con la entrada CE de cada flip-flop. Respetan `enable`:

| Elemento | Cómo |
|---|---|
| `pc_reg`, IF/ID (y `ena` de `imem`) | `en_pc`, `en_if_id` (con el stall) |
| ID/EX, EX/MEM | `en_id_ex`, `en_ex_mem` |
| MEM/WB (y `ena` de `dmem`) | `en_mem_wb`; la escritura de `dmem` solo ocurre con `ena = 1` |
| Escritura del banco de registros (§4.2) | `we = wb_reg_write & enable` |
| `halted` (§7.3) y avisos de acceso (§6.4) | solo se actualizan con `enable = 1` |

No usan `enable`: la lógica combinacional, la Debug Unit, la UART y el puerto B de las BRAM.
`core_rst` tiene prioridad sobre `enable`, para limpiar el core con el core detenido. Todo
elemento con estado que se agregue al core tiene que conectar `enable` (o un `en_*`).

### 10.5 Salto tomado

Cuando la resolución de saltos (§5.3) pone `redirect = 1`, las dos instrucciones que entraron
después del salto (en ID y en IF) siguieron el camino `PC + 4` y no deben ejecutarse. En el
mismo flanco:

- el PC toma `redirect_pc`;
- `flush_id_ex = 1`: la instrucción que estaba en ID se convierte en burbuja;
- `flush_if_id = 1`: la que la BRAM está entregando queda con `if_id_valid = 0`.

Ninguna de las dos llegó a escribir nada (los efectos se producen en MEM y WB), así que
anularlas es suficiente. Es equivalente a predecir siempre "no tomado".

| Caso | Ciclos perdidos |
|---|:---:|
| `beq`/`bne` no tomado | 0 |
| `beq`/`bne` tomado | 2 |
| `jal`, `jalr` | 2 |
| Salto que usa el resultado de la instrucción anterior (aritmética) | +0 (forwarding a EX) |
| Salto que usa el dato de un load inmediatamente anterior | +1 (stall de load-use, §10.3) |

Resolver en ID ahorraría un ciclo en el salto tomado, pero agregaría un stall cuando el salto
depende de la instrucción anterior, que es el caso más común; predecir los saltos hacia atrás
como tomados ahorra un ciclo por iteración de lazo, a cambio de una segunda fuente de
redirección. La comparación medida y el porqué de la elección están en la decisión [012](../decisiones/012_resolucion-saltos.md).

Ejemplo ([`riesgo_salto.png`](../diagramas/riesgo_salto.png)):

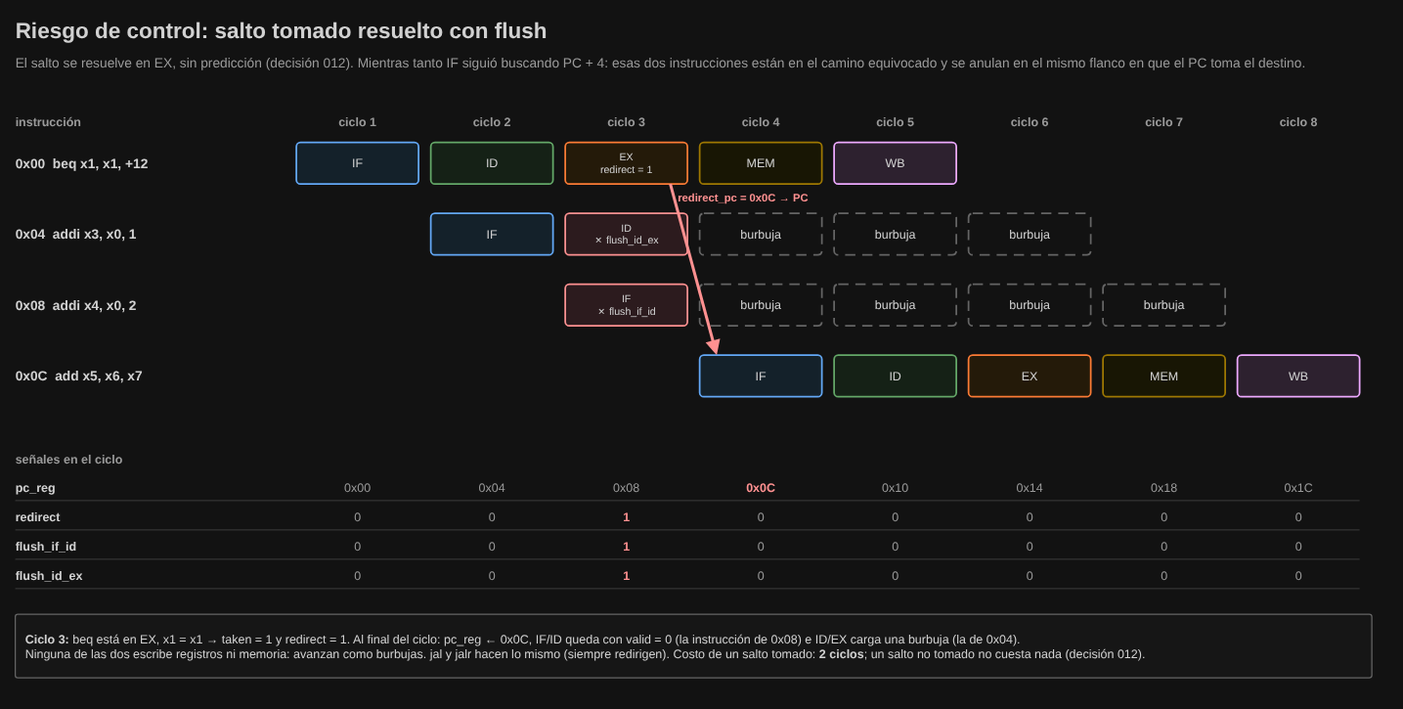
[picture p6: docs/diagramas/riesgo_salto.png]
Salto tomado resuelto con flush


### 10.6 Riesgos estructurales

Un riesgo estructural aparece cuando dos instrucciones necesitan el mismo recurso en el mismo
ciclo. Recursos compartidos del diseño:

| Recurso | Quién lo usa | ¿Riesgo? | Por qué |
|---|---|---|---|
| Memoria de instrucciones y de datos | IF y MEM, en el mismo ciclo | **No** | Son memorias separadas (Harvard): IF usa la de programa y MEM la de datos. |
| Banco de registros | ID lee dos registros y WB escribe uno, en el mismo ciclo | **Sí, resuelto** | Tiene 2 puertos de lectura y 1 de escritura propios. Si ID lee el registro que WB escribe, el bypass interno entrega el dato nuevo ([007](../decisiones/007_banco-registros.md)). No hace falta frenar. |
| Puerto de escritura del banco | WB | **No** | Todas las instrucciones escriben en la misma etapa: a lo sumo una escritura por ciclo. |
| ALU | EX | **No** | `PC + 4` (IF y EX) y `PC + imm` tienen sumadores propios; la ALU no se comparte. |
| Etapas multiciclo | — | **No hay** | Sin extensión M ni punto flotante, cada etapa tarda un ciclo y queda libre para la instrucción siguiente. |
| Puerto B de las BRAM y 3.er puerto del banco | Debug Unit | **No** | Son puertos propios. La Debug Unit escribe la memoria de programa con el core en reset (`LOAD`) y lee memoria y registros con `enable = 0`, cuando el core no los está usando (I-06). |

Conclusión: ningún recurso compartido obliga a frenar el pipeline. El único conflicto real
(ID y WB sobre el banco de registros) se resuelve dentro del banco y no cuesta ciclos. Todos
los stalls y flush del pipeline vienen de riesgos de datos (load-use) y de control (saltos).

### 10.7 Casos para el plan de verificación

Cada mecanismo de esta sección tiene que aparecer en algún programa de prueba (plan en [`verificacion.md`](verificacion.md) §4.2, I-11):

- Forwarding desde EX/MEM y desde MEM/WB, en `rs1` y en `rs2`.
- Las dos instrucciones anteriores escriben el mismo registro (gana EX/MEM).
- Destino `x0` en la instrucción anterior (no se reenvía).
- Dependencia a distancia 3 (bypass del banco).
- Load-use en `rs1` y en `rs2`; load seguido de `sw` que guarda el dato; load seguido de `beq`.
- Load seguido de una instrucción que no depende de él (sin stall).
- Salto tomado y no tomado, `jal` y `jalr`; salto que depende de la instrucción anterior.
- Stall con un HALT en ID (§3.4) y `STEP` en medio de un stall.

---

## 11. Relación con otros documentos

| Tema | Dónde |
|---|---|
| Codificación y comportamiento de HALT | [`decisiones/001_instruccion-halt.md`](../decisiones/001_instruccion-halt.md) |
| Instrucciones no reconocidas y `funct3`/`funct7` no soportados | [`decisiones/024_instrucciones-no-soportadas.md`](../decisiones/024_instrucciones-no-soportadas.md); filtro en el toolchain: [`decisiones/025_filtro-de-palabras-en-el-toolchain.md`](../decisiones/025_filtro-de-palabras-en-el-toolchain.md) |
| Integración de memorias sincrónicas | [`decisiones/009_memorias-sincronicas.md`](../decisiones/009_memorias-sincronicas.md) |
| Banco de registros y conflicto ID/WB | [`decisiones/007_banco-registros.md`](../decisiones/007_banco-registros.md) |
| Detección de riesgos, stall y forwarding | §10 y [`decisiones/011_deteccion-load-use.md`](../decisiones/011_deteccion-load-use.md) |
| Paso a paso sin intervenir el clock (`enable`) | §10.4 y [`decisiones/018_paso-a-paso-sin-clock.md`](../decisiones/018_paso-a-paso-sin-clock.md) |
| Interfaz de debug del core (buses de latch) y módulo `if_stage` | [`decisiones/023_interfaz-debug-del-core.md`](../decisiones/023_interfaz-debug-del-core.md) |
| Control de la ALU en ID, sin módulo `alu_control` | §4.5 y [`decisiones/026_control-de-alu-en-id.md`](../decisiones/026_control-de-alu-en-id.md) |
| Resolución de saltos | §5.3, §10.5 y [`decisiones/012_resolucion-saltos.md`](../decisiones/012_resolucion-saltos.md) |
| Tamaños, direcciones, BRAM y política de acceso a memoria | [`memoria.md`](memoria.md) y decisiones [013](../decisiones/013_tamano-y-mapa-de-memorias.md) a [016](../decisiones/016_acceso-por-byte.md) |
| Qué lógica de MEM va en `dmem` (extensión en WB, mapa de usadas en la Debug Unit) | §6.6 y [`decisiones/027_logica-de-mem-en-dmem.md`](../decisiones/027_logica-de-mem-en-dmem.md) |
| Contenido del dump de latches | I-06 (`protocolo_debug.md`) |
