moreyrajulian/arquitectura_de_computadoras/docs/spec/isa.md

## Instructions Set Architecture

| Instruccion | Description | Type | opcode | f3 | f7 | Operation (C type) |
| --- | --- | --- | --- | --- | --- | --- |
| add | add | R-type | 0110011 | 000 | 0000000 | rd = rs1 + rs2 |
| sub | substract | R-type | 0110011 | 000 | 0100000 | rd = rs1 - rs2 |
| sll | shfit left logical | R-type | 0110011 | 001 | 0000000 | rd = rs1 << rs2[4:0] |
| srl | shift right logical | R-type | 0110011 | 101 | 0000000 | rd = rs1 >> rs2[4:0] |
| sra | shift right arithmetic | R-type | 0110011 | 101 | 0100000 | rd = rs1 >>a rs2[4:0] |
| and | and | R-type | 0110011 | 111 | 0000000 | rd = rs1 & rs2 |
| or | or | R-type | 0110011 | 110 | 0000000 | rd = rs1 | rs2 |
| xor | exclusive or | R-type | 0110011 | 100 | 0000000 | rd = rs1 ^ rs2 |
| slt | set if less than | R-type | 0110011 | 010 | 0000000 | rd = (rs1 < rs2) ? 1 : 0 |
| sltu | set if less than unsigned | R-type | 0110011 | 011 | 0000000 |  rd = (rs1 <u rs2) ? 1 : 0 |
| lb | load byte | I-type | 0000011 | 000 | - | rd = SignExt(MEM[rs1+imm][7:0]) |
| lh | load half | I-type | 0000011 | 001 | - | rd = SignExt(MEM[rs1+imm][15:0]) |
| lw | load word | I-type | 0000011 | 010 | - | rd = MEM[rs1 + SignExt(imm)] |
| lbu | load byte, unsigned | I-type | 0000011 | 100 | - | rd = ZeroExt(MEM[rs1+imm][7:0]) |
| lhu | load half, unsigned | I-type | 0000011 | 101 | - | rd = ZeroExt(MEM[rs1+imm][15:0]) |
| addi | add immediate | I-type | 0010011 | 000 | - | rd = rs1 + SignExt(imm) |
| andi | and immediate | I-type | 0010011 | 111 | - | rd = rs1 & SignExt(imm) |
| ori | or immediate | I-type | 0010011 | 110 | - | rd = rs1 | SignExt(imm) |
| xori | exclusive or imm. | I-type | 0010011 | 100 | - | rd = rs1 ^ SignExt(imm) |
| slti | set if less than imm. | I-type | 0010011 | 010 | - | rd = (rs1 < SignExt(imm)) ? 1 : 0 |
| sltiu | set if less than imm. unsigned | I-type | 0010011 | 011 | - | rd = (rs1 <u SignExt(imm)) ? 1 : 0 |
| slli | shfit left log. imm. | I-type | 0010011 | 001 | 0000000 | rd = rs1 << shamt |
| srli | shfit right log. imm. | I-type | 0010011 | 101 | 0000000 |  rd = rs1 >> shamt |
| srai | shift right arith. imm | I-type | 0010011 | 101 | 0100000 | rd = rs1 >>a shamt |
| jalr | jump and link register | I-type | 1100111 | 000 | - | rd = PC + 4; PC = (rs1+imm) & ~1 |
| jal | jump and link | J-type | 1101111 | - | - | rd = PC + 4; PC += imm |
| sb | store byte | S-type | 0100011 | 000 | - | MEM[rs1+imm][7:0] = rs2[7:0] |
| sh | store half | S-type | 0100011 | 001 | - | MEM[rs1+imm][15:0] = rs2[15:0] |
| sw | store word | S-type | 0100011 | 010 | - | MEM[rs1 + SignExt(imm)] = rs2 |
| beq | branch if equal | B-type | 1100011 | 000 | - | if (rs1 == rs2) PC += imm |
| bne | branch if not equal | B-type | 1100011 | 001 | - | if (rs1 != rs2) PC += imm |
| lui | load upper immediate | U-type | 0110111 | - | - | rd = imm << 12 |
| halt (ebreak) | halt: stops fetch, flushes pipeline and warns the Debug Unit | I-type | 1110011 | 000 | - | stops fetch; when exits WB stage, halted = 1  |

## Formatos de instrucción y construcción del Inmediato

La columna de _Type_ de la tabla indica el formato de cada instrucción. La figura muestra los seis formatos (R, I, S, B, U, J) y, para cada formato con inmediato, de qué bits de la instrucción sale cada bit del inmediato de 32 bits que entrega el extensor. Los colores identifican los bits de origen en la instrucción y son los mismos en todos los formatos.

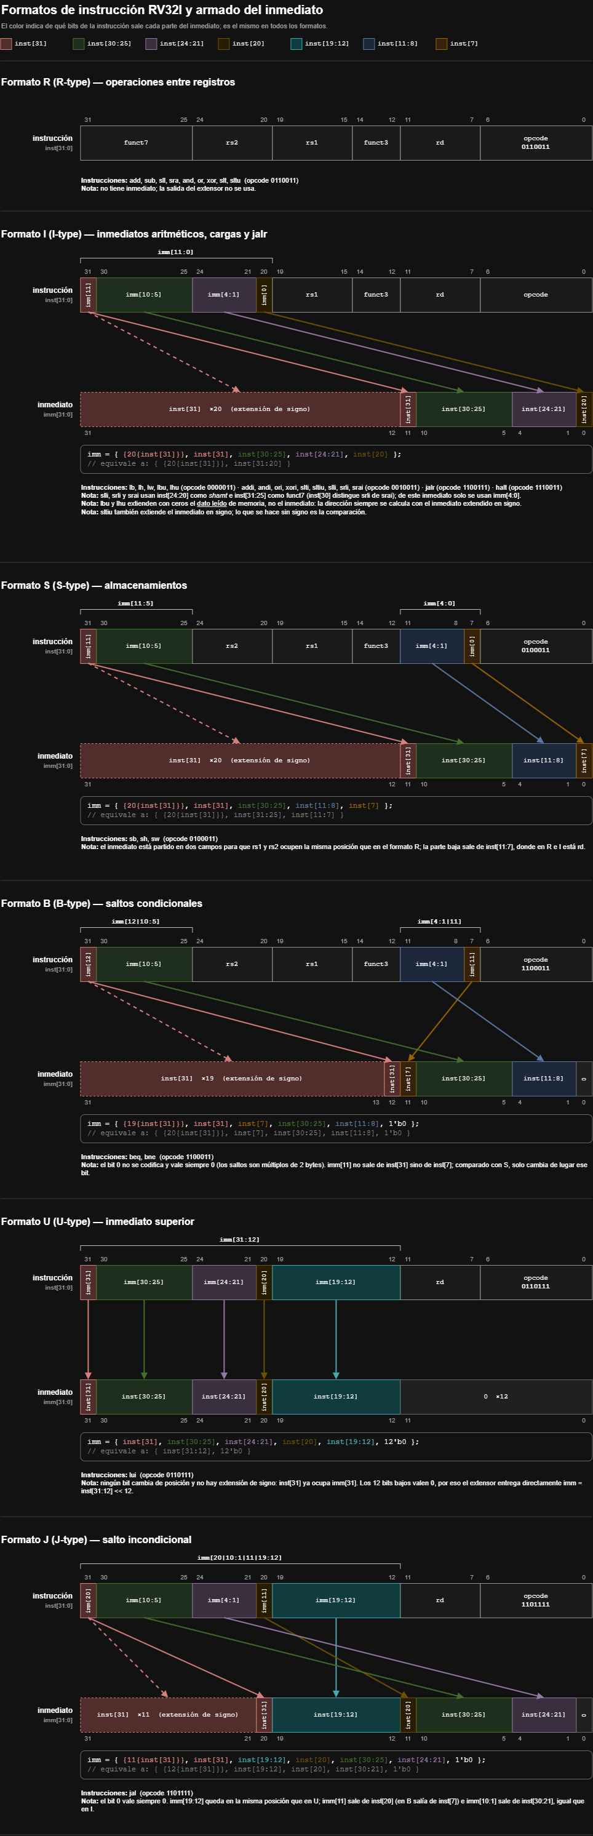
[picture p8: docs/diagramas/formatos.png]
Formatos de instrucción


Fuente editable: `docs/diagramas/formatos.drawio`

| Formato | Inmediato de 32 bits (Verilog) |
| --- | --- |
| R | - (no tiene inmediato) |
| I | `{ {20{inst[31]}}, inst[31:20] }` |
| S | `{ {20{inst[31]}}, inst[31:25], inst[11:7] }` |
| B | `{ {19{inst[31]}}, inst[31], inst[7], inst[30:25], inst[11:8], 1'b0 }` |
| U | `{ inst[31:12], 12'b0 }` |
| J | `{ {12{inst[31]}}, inst[19:12], inst[20], inst[30:21], 1'b0 }` |
