moreyrajulian/arquitectura_de_computadoras/docs/decisiones/_plantilla.md

# NNN - Título de la decisión

- **Estado:** propuesta | aceptada | reemplazada por NNN
  <!-- Se escribe `propuesta`; el último commit del PR, ya aprobado, la pasa a `aceptada`.
       Si quedan puntos abiertos, van en Consecuencias. Regla completa en docs/README.md. -->
- **Fecha:** AAAA-MM-DD
- **Autores:**

## Contexto
Qué problema hay que resolver y qué restricciones lo condicionan
(consigna, recursos de la Basys 3, tiempos, interacción con otros módulos).

## Opciones consideradas
1. **Opción A:** descripción, ventajas, desventajas.
2. **Opción B:** descripción, ventajas, desventajas.

## Decisión
Qué se eligió y el porqué, en pocas líneas.

## Consecuencias
Qué implica esta decisión: qué módulos afecta, qué queda más simple o más difícil,
qué habría que revisar si cambia algún supuesto. Si la nota se mergea con puntos sin
cerrar, se listan acá como **Puntos abiertos**.
