moreyrajulian/arquitectura_de_computadoras/fpga/tp2_uart/alu_top.v

`timescale 1ns / 1ps

module alu_top
#(
    parameter NB_DATA = 8
)
(
    input  wire clk, reset,
    // interfaz Rx (lectura)
    input  wire [NB_DATA-1:0] r_data,
    input  wire rx_empty,
    output reg  rd,
    // interfaz Tx (escritura)
    input  wire tx_full,
    output reg  wr,
    output reg  [NB_DATA-1:0] w_data
);
    localparam NB_OP = 6;

    // estados de la FSM
    localparam [2:0]
        S_OP      = 3'd0, // esperando byte de opcode
        S_A       = 3'd1, // esperando byte del operando A
        S_B       = 3'd2, // esperando byte del operando B
        S_COMPUTE = 3'd3, // captura el resultado del alu_core (1 ciclo)
        S_TX      = 3'd4; // esperando poder escribir el resultado

    reg [2:0] state_reg, state_next;
    reg [NB_OP-1:0] op_reg, op_next;
    reg signed [NB_DATA-1:0] a_reg, a_next;
    reg signed [NB_DATA-1:0] b_reg, b_next;
    reg signed [NB_DATA-1:0] result_reg, result_next;

    // salida combinacional del núcleo aritmético (alu pura, sin estado)
    wire signed [NB_DATA-1:0] alu_result;

    // instanciación estructural: fuera de cualquier always, conectada
    // permanentemente a los registros de operandos/opcode
    alu_tp2 #(.NB_DATA(NB_DATA)) alu_unit (
        .i_a      (a_reg),
        .i_b      (b_reg),
        .i_op     (op_reg),
        .o_result (alu_result)
    );

    // registro de estado
    always @(posedge clk) begin
        if (reset) begin
            state_reg  <= S_OP;
            op_reg     <= 0;
            a_reg      <= 0;
            b_reg      <= 0;
            result_reg <= 0;
        end else begin
            state_reg  <= state_next;
            op_reg     <= op_next;
            a_reg      <= a_next;
            b_reg      <= b_next;
            result_reg <= result_next;
        end
    end

    // logica de siguiente estado
    always @(*) begin
        // valores por defecto (se mantienen)
        state_next  = state_reg;
        op_next     = op_reg;
        a_next      = a_reg;
        b_next      = b_reg;
        result_next = result_reg;
        rd          = 1'b0;
        wr          = 1'b0;
        w_data      = {NB_DATA{1'b0}};

        case (state_reg)
            S_OP: begin
                if (!rx_empty) begin
                    op_next    = r_data[NB_OP-1:0];
                    rd         = 1'b1;   // pulso de 1 ciclo
                    state_next = S_A;
                end
            end
            S_A: begin
                if (!rx_empty) begin
                    a_next     = r_data;
                    rd         = 1'b1;
                    state_next = S_B;
                end
            end
            S_B: begin
                if (!rx_empty) begin
                    b_next     = r_data;
                    rd         = 1'b1;
                    state_next = S_COMPUTE;
                end
            end
            S_COMPUTE: begin
                result_next = alu_result;
                state_next  = S_TX;
            end
            S_TX: begin
                if (!tx_full) begin
                    w_data     = result_reg;
                    wr         = 1'b1;   // pulso de 1 ciclo
                    state_next = S_OP;
                end
            end
            default: state_next = S_OP;
        endcase
    end
endmodule
