moreyrajulian/arquitectura_de_computadoras/fpga/tp1_alu/top.v

`timescale 1ns / 1ps
//////////////////////////////////////////////////////////////////////////////////
// Company: 
// Engineer: 
// 
// Create Date: 08/31/2026 05:38:33 PM
// Design Name: 
// Module Name: top
// Project Name: 
// Target Devices: 
// Tool Versions: 
// Description: `timescale 1ns / 1ps

//======================================================================
// Top del TP1: los switches cargan A, B y el opcode en registros mediante
// tres pulsadores; el resultado se registra y se muestra en los LEDs.
//
//   SWITCHES --+--> [reg A ]--+
//              |              +--> ALU --> [reg result] --> LEDS
//              +--> [reg B ]--+
//              |              |
//              +--> [reg OP]--+
//======================================================================

module top
#(
    parameter integer NB_DATA = 8,   // ancho del bus de datos
    parameter integer NB_OP   = 6,   // ancho del codigo de operacion
    parameter integer NB_SW   = 8    // switches usados (>= NB_DATA y >= NB_OP)
)
(
    input  wire               clk,
    input  wire               i_reset,     // btnC
    input  wire [NB_SW-1:0]   i_sw,
    input  wire               i_btn_a,     // btnL -> carga dato A
    input  wire               i_btn_b,     // btnR -> carga dato B
    input  wire               i_btn_op,    // btnU -> carga opcode
    output wire [NB_DATA:0] o_led
);

    reg [NB_DATA-1:0] reg_a;
    reg [NB_DATA-1:0] reg_b;
    reg [NB_OP-1:0]   reg_op;
    reg [NB_DATA:0] reg_result;

    wire [NB_DATA:0] alu_result;

    //------------------------------------------------------------------
    // Registros de entrada
    //------------------------------------------------------------------
    always @(posedge clk) begin
        if (i_reset) begin
            reg_a  <= {NB_DATA{1'b0}};
            reg_b  <= {NB_DATA{1'b0}};
            reg_op <= {NB_OP{1'b0}};
        end else begin
            if (i_btn_a)  reg_a  <= i_sw[NB_DATA-1:0];
            if (i_btn_b)  reg_b  <= i_sw[NB_DATA-1:0];
            if (i_btn_op) reg_op <= i_sw[NB_OP-1:0];
        end
    end

    //------------------------------------------------------------------
    // ALU
    //------------------------------------------------------------------
    alu #(
        .NB_DATA (NB_DATA),
        .NB_OP   (NB_OP)
    ) u_alu (
        .i_a      (reg_a),
        .i_b      (reg_b),
        .i_op     (reg_op),
        .o_result (alu_result)
    );

    //------------------------------------------------------------------
    // Registro de salida: cierra el camino reg -> logica -> reg, que es
    // lo que el analisis de tiempo de Vivado puede medir.
    //------------------------------------------------------------------
    always @(posedge clk) begin
        if (i_reset) reg_result <= {NB_DATA+1{1'b0}};
        else         reg_result <= alu_result;
    end

    assign o_led = reg_result;

endmodule
