moreyrajulian/arquitectura_de_computadoras/tb/unit/id_ex_reg_tb.v

`timescale 1ns / 1ps

//======================================================================
// id_ex_reg_tb
//
// Testbench autoverificante de id_ex_reg (docs/spec/verificacion.md
// §3.1: "igual que IF/ID; además, los 161 bits se conservan intactos
// con en = 1").
//
// Casos:
//   - Reset carga burbuja (valid = 0 y control en 0), también con
//     en = 0 (rst > en) y con flush = 1
//   - en = 1 sin flush carga los 20 campos
//   - flush carga burbuja aunque la instrucción de ID traiga todo el
//     control en 1, y al soltarlo vuelve a cargar
//   - Una burbuja de IF/ID (valid = 0, control en 0) pasa como burbuja
//   - en = 0 conserva los 161 bits, también con flush = 1 (core
//     detenido durante un stall, pipeline.md §2 y §10.4)
//   - Bit a bit: con en = 1, un 1 (y un 0) en cada posición de los 161
//     bits llega a su puerto y a su lugar de o_latch; detecta campos
//     cruzados o truncados
//   - Barrido exhaustivo de {rst, en, flush} x i_valid desde un estado
//     válido
//   - Estímulo aleatorio con semilla fija contra un modelo de §2
//
// El orden de los campos (pipeline.md §8, el primero en los bits altos)
// lo arma este testbench concatenando sus entradas y los puertos de
// salida uno por uno; no usa el agrupamiento interno del módulo.
// Como en la traza del modelo (tools/isasim/isasim/latches.py), en una
// burbuja solo se comparan valid y las 11 señales de control: los datos
// no importan (pipeline.md §2) y no tienen reset.
//
// Los estímulos cambian en el flanco de bajada y se comprueban en el
// flanco de bajada siguiente, después de un flanco de subida.
//======================================================================

module id_ex_reg_tb;

    localparam integer NB_PC       = 32;
    localparam integer NB_DATA     = 32;
    localparam integer NB_ADDR     = 5;
    localparam integer NB_FUNCT3   = 3;
    localparam integer NB_ALU_CTRL = 4;
    localparam integer NB_LATCH    = 161;    // pipeline.md §8
    localparam integer NB_CTRL     = 14;     // alu_ctrl (4) + 10 señales de 1 bit
    localparam integer T_CLK       = 10;     // ns, 100 MHz como la Basys 3
    localparam integer N_RANDOM    = 2000;   // ciclos de estímulo aleatorio
    localparam integer MAX_CYCLES  = 5000;   // watchdog
    localparam integer SEED        = 38;     // semilla fija (issue #38)

    // Bits que se comparan en una burbuja: valid (bit 160) y control
    // (bits 13:0, de alu_ctrl a halt)
    localparam [NB_LATCH-1:0] MASK_BURBUJA = {1'b1, {(NB_LATCH-1-NB_CTRL){1'b0}}, {NB_CTRL{1'b1}}};
    localparam [NB_LATCH-1:0] MASK_TODO    = {NB_LATCH{1'b1}};
    localparam [NB_LATCH-1:0] BIT_VALID    = {1'b1, {(NB_LATCH-1){1'b0}}};

    reg                    tb_clk;
    reg                    tb_rst;
    reg                    tb_en;
    reg                    tb_flush;

    reg                    tb_valid;
    reg  [NB_PC-1:0]       tb_pc;
    reg  [NB_DATA-1:0]     tb_rs1_data;
    reg  [NB_DATA-1:0]     tb_rs2_data;
    reg  [NB_DATA-1:0]     tb_imm;
    reg  [NB_ADDR-1:0]     tb_rs1;
    reg  [NB_ADDR-1:0]     tb_rs2;
    reg  [NB_ADDR-1:0]     tb_rd;
    reg  [NB_FUNCT3-1:0]   tb_funct3;
    reg  [NB_ALU_CTRL-1:0] tb_alu_ctrl;
    reg                    tb_alu_src_a;
    reg                    tb_alu_src_b;
    reg                    tb_branch;
    reg                    tb_jal;
    reg                    tb_jalr;
    reg                    tb_mem_read;
    reg                    tb_mem_write;
    reg                    tb_reg_write;
    reg                    tb_mem_to_reg;
    reg                    tb_halt;

    wire                   tb_o_valid;
    wire [NB_PC-1:0]       tb_o_pc;
    wire [NB_DATA-1:0]     tb_o_rs1_data;
    wire [NB_DATA-1:0]     tb_o_rs2_data;
    wire [NB_DATA-1:0]     tb_o_imm;
    wire [NB_ADDR-1:0]     tb_o_rs1;
    wire [NB_ADDR-1:0]     tb_o_rs2;
    wire [NB_ADDR-1:0]     tb_o_rd;
    wire [NB_FUNCT3-1:0]   tb_o_funct3;
    wire [NB_ALU_CTRL-1:0] tb_o_alu_ctrl;
    wire                   tb_o_alu_src_a;
    wire                   tb_o_alu_src_b;
    wire                   tb_o_branch;
    wire                   tb_o_jal;
    wire                   tb_o_jalr;
    wire                   tb_o_mem_read;
    wire                   tb_o_mem_write;
    wire                   tb_o_reg_write;
    wire                   tb_o_mem_to_reg;
    wire                   tb_o_halt;
    wire [NB_LATCH-1:0]    tb_o_latch;

    // Entradas y salidas en el orden de pipeline.md §8
    wire [NB_LATCH-1:0] tb_entrada = {
        tb_valid, tb_pc, tb_rs1_data, tb_rs2_data, tb_imm, tb_rs1, tb_rs2,
        tb_rd, tb_funct3, tb_alu_ctrl, tb_alu_src_a, tb_alu_src_b, tb_branch,
        tb_jal, tb_jalr, tb_mem_read, tb_mem_write, tb_reg_write,
        tb_mem_to_reg, tb_halt
    };
    wire [NB_LATCH-1:0] tb_salida = {
        tb_o_valid, tb_o_pc, tb_o_rs1_data, tb_o_rs2_data, tb_o_imm, tb_o_rs1,
        tb_o_rs2, tb_o_rd, tb_o_funct3, tb_o_alu_ctrl, tb_o_alu_src_a,
        tb_o_alu_src_b, tb_o_branch, tb_o_jal, tb_o_jalr, tb_o_mem_read,
        tb_o_mem_write, tb_o_reg_write, tb_o_mem_to_reg, tb_o_halt
    };

    integer errors;
    integer checks;
    integer seed;
    integer i;
    integer combo;

    reg [NB_LATCH-1:0] modelo;
    reg [NB_LATCH-1:0] patron_a;
    reg [NB_LATCH-1:0] patron_b;
    reg [NB_LATCH-1:0] patron;

    id_ex_reg #(
        .NB_PC       (NB_PC),
        .NB_DATA     (NB_DATA),
        .NB_ADDR     (NB_ADDR),
        .NB_FUNCT3   (NB_FUNCT3),
        .NB_ALU_CTRL (NB_ALU_CTRL)
    ) u_dut (
        .i_clk        (tb_clk),
        .i_rst        (tb_rst),
        .i_en         (tb_en),
        .i_flush      (tb_flush),
        .i_valid      (tb_valid),
        .i_pc         (tb_pc),
        .i_rs1_data   (tb_rs1_data),
        .i_rs2_data   (tb_rs2_data),
        .i_imm        (tb_imm),
        .i_rs1        (tb_rs1),
        .i_rs2        (tb_rs2),
        .i_rd         (tb_rd),
        .i_funct3     (tb_funct3),
        .i_alu_ctrl   (tb_alu_ctrl),
        .i_alu_src_a  (tb_alu_src_a),
        .i_alu_src_b  (tb_alu_src_b),
        .i_branch     (tb_branch),
        .i_jal        (tb_jal),
        .i_jalr       (tb_jalr),
        .i_mem_read   (tb_mem_read),
        .i_mem_write  (tb_mem_write),
        .i_reg_write  (tb_reg_write),
        .i_mem_to_reg (tb_mem_to_reg),
        .i_halt       (tb_halt),
        .o_valid      (tb_o_valid),
        .o_pc         (tb_o_pc),
        .o_rs1_data   (tb_o_rs1_data),
        .o_rs2_data   (tb_o_rs2_data),
        .o_imm        (tb_o_imm),
        .o_rs1        (tb_o_rs1),
        .o_rs2        (tb_o_rs2),
        .o_rd         (tb_o_rd),
        .o_funct3     (tb_o_funct3),
        .o_alu_ctrl   (tb_o_alu_ctrl),
        .o_alu_src_a  (tb_o_alu_src_a),
        .o_alu_src_b  (tb_o_alu_src_b),
        .o_branch     (tb_o_branch),
        .o_jal        (tb_o_jal),
        .o_jalr       (tb_o_jalr),
        .o_mem_read   (tb_o_mem_read),
        .o_mem_write  (tb_o_mem_write),
        .o_reg_write  (tb_o_reg_write),
        .o_mem_to_reg (tb_o_mem_to_reg),
        .o_halt       (tb_o_halt),
        .o_latch      (tb_o_latch)
    );

    initial tb_clk = 1'b0;
    always #(T_CLK/2) tb_clk = ~tb_clk;

    //------------------------------------------------------------------
    // Modelo de referencia, escrito a partir de pipeline.md §2 y §8:
    // prioridad rst > en > flush; rst y flush cargan burbuja (valid y
    // control en 0). Los datos de una burbuja no se comparan, así que el
    // modelo no necesita fijar qué hace el flush con ellos.
    //------------------------------------------------------------------
    task modelo_ciclo;
        input                rst;
        input                en;
        input                flush;
        input [NB_LATCH-1:0] entrada;
        begin
            if (rst)
                modelo = modelo & ~MASK_BURBUJA;
            else if (en) begin
                if (flush)
                    modelo = entrada & ~MASK_BURBUJA;
                else
                    modelo = entrada;
            end
        end
    endtask

    //------------------------------------------------------------------
    // Chequeo con etiqueta, para que el log diga qué caso falló
    //------------------------------------------------------------------
    task chk;
        input [8*44-1:0]     name;
        input [NB_LATCH-1:0] obtenido;
        input [NB_LATCH-1:0] esperado;
        begin
            checks = checks + 1;
            if (obtenido !== esperado) begin
                errors = errors + 1;
                $display("[%0t] ERROR %0s | dut=0x%h esperado=0x%h",
                         $time, name, obtenido, esperado);
            end
        end
    endtask

    // Compara los puertos y o_latch contra el modelo; en una burbuja,
    // solo valid y control
    task chk_latch;
        input [8*44-1:0] name;
        reg [NB_LATCH-1:0] mask;
        begin
            mask = modelo[NB_LATCH-1] ? MASK_TODO : MASK_BURBUJA;
            chk(name, tb_salida & mask, modelo & mask);
            chk(name, tb_o_latch & mask, modelo & mask);
        end
    endtask

    // Pone un juego de entradas en el orden de §8
    task poner;
        input [NB_LATCH-1:0] v;
        begin
            {tb_valid, tb_pc, tb_rs1_data, tb_rs2_data, tb_imm, tb_rs1, tb_rs2,
             tb_rd, tb_funct3, tb_alu_ctrl, tb_alu_src_a, tb_alu_src_b, tb_branch,
             tb_jal, tb_jalr, tb_mem_read, tb_mem_write, tb_reg_write,
             tb_mem_to_reg, tb_halt} = v;
        end
    endtask

    // Aplica un juego de entradas durante un ciclo (un flanco de subida)
    // y actualiza el modelo
    task ciclo;
        input                rst;
        input                en;
        input                flush;
        input [NB_LATCH-1:0] entrada;
        begin
            tb_rst   = rst;
            tb_en    = en;
            tb_flush = flush;
            poner(entrada);
            modelo_ciclo(rst, en, flush, entrada);
            @(negedge tb_clk);
        end
    endtask

    // 161 bits al azar
    function [NB_LATCH-1:0] al_azar;
        input dummy;
        begin
            al_azar = {$random(seed), $random(seed), $random(seed),
                       $random(seed), $random(seed), $random(seed)};
        end
    endfunction

    //------------------------------------------------------------------
    // Secuencia
    //------------------------------------------------------------------
    initial begin
        errors = 0;
        checks = 0;
        seed   = SEED;
        modelo = {NB_LATCH{1'b0}};
        tb_rst   = 1'b1;
        tb_en    = 1'b0;
        tb_flush = 1'b0;
        poner({NB_LATCH{1'b0}});

        // Instrucción con todo el control en 1 y datos que no se
        // confunden entre campos; patron_b difiere en todos los bits
        patron_a = {1'b1, 32'h0000_0104, 32'h1111_1111, 32'h2222_2222,
                    32'hFFFF_F800, 5'd1, 5'd2, 5'd3, 3'b101,
                    4'b1101, 10'b11_1111_1111};
        patron_b = ~patron_a;

        // Reset: burbuja, aunque la entrada sea válida y con control en 1
        @(negedge tb_clk);
        ciclo(1'b1, 1'b1, 1'b0, patron_a);
        chk_latch("reset");
        ciclo(1'b1, 1'b0, 1'b0, patron_a);
        chk_latch("reset con en = 0");
        ciclo(1'b1, 1'b1, 1'b1, patron_a);
        chk_latch("reset con flush");

        // Carga normal
        ciclo(1'b0, 1'b1, 1'b0, patron_a);
        chk_latch("carga");
        chk("carga: los 161 bits", tb_salida, patron_a);
        chk("carga: o_latch", tb_o_latch, patron_a);

        // Una burbuja de IF/ID pasa como burbuja
        ciclo(1'b0, 1'b1, 1'b0, patron_a & ~MASK_BURBUJA);
        chk_latch("burbuja de IF/ID");

        // flush carga burbuja aunque ID traiga todo el control en 1
        ciclo(1'b0, 1'b1, 1'b0, patron_a);
        ciclo(1'b0, 1'b1, 1'b1, patron_a);
        chk_latch("flush carga burbuja");
        chk("flush: control en 0", tb_salida & MASK_BURBUJA, {NB_LATCH{1'b0}});
        ciclo(1'b0, 1'b1, 1'b1, patron_b | BIT_VALID);
        chk_latch("flush seguido");
        ciclo(1'b0, 1'b1, 1'b0, patron_b | BIT_VALID);
        chk_latch("carga tras flush");

        // en = 0 conserva los 161 bits
        ciclo(1'b0, 1'b1, 1'b0, patron_a);
        for (i = 0; i < 3; i = i + 1) begin
            ciclo(1'b0, 1'b0, 1'b0, al_azar(0));
            chk_latch("en = 0 conserva");
            chk("en = 0 conserva: los 161 bits", tb_salida, patron_a);
        end

        // Core detenido durante un stall: en = 0 gana sobre flush = 1
        for (i = 0; i < 3; i = i + 1) begin
            ciclo(1'b0, 1'b0, 1'b1, al_azar(0));
            chk_latch("en = 0 conserva con flush");
            chk("en = 0 con flush: los 161 bits", tb_salida, patron_a);
        end
        // Al volver enable, el flush pendiente del stall carga burbuja
        ciclo(1'b0, 1'b1, 1'b1, patron_b | BIT_VALID);
        chk_latch("flush al volver enable");
        // Una burbuja retenida sigue siendo burbuja
        ciclo(1'b0, 1'b0, 1'b0, patron_a);
        chk_latch("en = 0 conserva burbuja");

        // rst gana sobre en = 0 y sobre flush
        ciclo(1'b0, 1'b1, 1'b0, patron_a);
        ciclo(1'b1, 1'b0, 1'b0, patron_b | BIT_VALID);
        chk_latch("rst con en = 0");
        ciclo(1'b0, 1'b1, 1'b0, patron_a);
        ciclo(1'b1, 1'b0, 1'b1, patron_b | BIT_VALID);
        chk_latch("rst con en = 0 y flush");

        // Bit a bit: un 1 y un 0 en cada posición, con valid = 1 para que
        // se comparen todos los bits. Cada puerto y o_latch tienen que
        // dar exactamente la entrada.
        for (i = 0; i < NB_LATCH; i = i + 1) begin
            patron = ({{(NB_LATCH-1){1'b0}}, 1'b1} << i) | BIT_VALID;
            ciclo(1'b0, 1'b1, 1'b0, patron);
            chk("un 1 por bit: puertos", tb_salida, patron);
            chk("un 1 por bit: o_latch", tb_o_latch, patron);
            if (tb_salida !== patron || tb_o_latch !== patron)
                $display("        bit %0d", i);
            patron = ~({{(NB_LATCH-1){1'b0}}, 1'b1} << i) | BIT_VALID;
            ciclo(1'b0, 1'b1, 1'b0, patron);
            chk("un 0 por bit: puertos", tb_salida, patron);
            chk("un 0 por bit: o_latch", tb_o_latch, patron);
            if (tb_salida !== patron || tb_o_latch !== patron)
                $display("        bit %0d", i);
        end

        // Barrido exhaustivo de {rst, en, flush} x i_valid desde un
        // estado válido, con una entrada distinta en todos los bits
        for (combo = 0; combo < 16; combo = combo + 1) begin
            ciclo(1'b0, 1'b1, 1'b0, patron_a);
            patron = combo[3] ? (patron_b | BIT_VALID) : (patron_b & ~BIT_VALID);
            ciclo(combo[2], combo[1], combo[0], patron);
            i = errors;
            chk_latch("barrido {rst,en,flush} x valid");
            if (errors != i)
                $display("        combo {valid,rst,en,flush} = %b", combo[3:0]);
        end

        // Estímulo aleatorio con semilla fija contra el modelo
        ciclo(1'b1, 1'b1, 1'b0, {NB_LATCH{1'b0}});
        for (i = 0; i < N_RANDOM; i = i + 1) begin
            patron = al_azar(0);
            patron[NB_LATCH-1] = (($random(seed) & 3) != 0);   // valid 3/4
            ciclo((($random(seed) & 31) == 0),                 // rst   1/32
                  (($random(seed) & 3)  != 0),                 // en    3/4
                  (($random(seed) & 7)  == 0),                 // flush 1/8
                  patron);
            chk_latch("aleatorio");
            chk("aleatorio: o_latch = puertos", tb_o_latch, tb_salida);
        end

        if (errors == 0)
            $display("TEST PASSED: %0d chequeos, 0 errores", checks);
        else
            $display("TEST FAILED: %0d errores sobre %0d chequeos", errors, checks);
        $finish;
    end

    // Watchdog: si la secuencia no termina, falla en vez de colgarse
    initial begin
        repeat (MAX_CYCLES) @(posedge tb_clk);
        $display("TEST FAILED: timeout de %0d ciclos", MAX_CYCLES);
        $finish;
    end

endmodule
