moreyrajulian/arquitectura_de_computadoras/fpga/tp1_alu/alu_tp1.v

`timescale 1ns / 1ps
//////////////////////////////////////////////////////////////////////////////////
// Company: FCEFyN
// Engineers: Costamagna, Matías
//            Moreyra, Julián
// Create Date: 26.08.2026 17:45:26
// Design Name: 
// Module Name: alu_tp1
// Project Name:
// Target Devices:
// Tool Versions:
// Description:
//
// Dependencies:
//
// Revision:
// Revision 0.01 - File Created
// Additional Comments:
//   ALU entregada en TP1 (rama tp1_signed_implementation), renombrada de
//   alu a alu_tp1: rtl/common/alu.v pasó a ser la ALU RV32I (I-28) y
//   create_project.tcl agrega rtl/ a todos los diseños.
//
//////////////////////////////////////////////////////////////////////////////////


module alu_tp1
#(
    parameter NB_DATA = 8, //ancho de los datos 
    parameter NB_OP = 6 //ancho del codigo para identificar la operacion que se quiere realizar
)
(
    input wire signed [NB_DATA-1:0] i_a,
    input wire signed [NB_DATA-1:0] i_b,
    input wire [NB_OP-1:0] i_op,
    output wire signed [NB_DATA:0] o_result
);
    //parametros locales para identificar los codigos de operacion
    localparam [NB_OP-1:0] OP_ADD = 6'b100000;
    localparam [NB_OP-1:0] OP_SUB = 6'b100010;
    localparam [NB_OP-1:0] OP_AND = 6'b100100;
    localparam [NB_OP-1:0] OP_OR  = 6'b100101;
    localparam [NB_OP-1:0] OP_XOR = 6'b100110;
    localparam [NB_OP-1:0] OP_SRA = 6'b000011;
    localparam [NB_OP-1:0] OP_SRL = 6'b000010;
    localparam [NB_OP-1:0] OP_NOR = 6'b100111;
    
    //bits de B usados como shift amount
    localparam NB_SHAMT = $clog2(NB_DATA);
    wire [NB_SHAMT-1:0] shamt = i_b[NB_SHAMT-1:0];
    
    reg signed [NB_DATA:0] result;
    
    always @(*) begin
        case (i_op)
            OP_ADD : result = i_a + i_b;
            OP_SUB : result = i_a - i_b;
            OP_AND : result = {1'b0, {i_a & i_b}};
            OP_OR  : result = {1'b0, {i_a | i_b}};
            OP_XOR : result = {1'b0, {i_a ^ i_b}};
            OP_NOR : result = {1'b0, {~(i_a | i_b)}};
            OP_SRA : result = $signed(i_a) >>> shamt;
            OP_SRL : result = {1'b0, {$unsigned(i_a) >>  shamt}};
            default: result = {NB_DATA{1'b0}}; //para no inferir un latch
        endcase
    end
    
    assign o_result = result;

endmodule
