moreyrajulian/arquitectura_de_computadoras/(commit log)

2026-09-02 Noveno LED para carry en operaciones aritmeticas
2026-09-02 Extra bit en el resultado de las operaciones aritmeticas
2026-09-02 Agregado de casos borde para todos los opcode
2026-09-07 parameter name in uart_tx
2026-09-09 Refactor ALU module to include FSM and UART interface
2026-09-09 Add intf_circ module for UART interface
2026-09-09 Integrate UART interface and ALU into top module
    Refactored top module to include UART interface and ALU functionality.
2026-09-09 Refactor uart_rx module with enhanced stop bit logic
2026-09-09 Revise Basys3 constraints for UART integration
    Updated constraints for Basys3 to reflect changes in input/output handling. Removed constraints for switches and LEDs as data is now serialized via UART.
2026-09-24 Implement UART finite state machine in Verilog
2026-09-24 Add UART RX datapath module
2026-09-24 Add uart_tx_datapath module for UART transmission
2026-09-24 Refactor uart_rx to use FSM and datapath modules
    Refactored uart_rx module to use FSM and datapath separation.
2026-09-24 Refactor uart_tx module into FSM and datapath
2026-09-24 chore: agregar README, script de proyecto Vivado y plantilla de PR
2026-09-24 docs: agregar README de fpga/ y docs/
2026-09-24 chore: agregar plantillas de issues y de decisiones
2026-09-26 docs(isa): codificacion del isa a utilizar con placeholder para la instruccion halt (definida en la I-08)
2026-09-28 docs(readme): correccion de la ruta de la imagen del diagrama del sistema
2026-09-28 docs(isa): cambio de la extensión de signo para lhu
    Se cambia la extensión de signo debido a que es una instrucción `unsigned` por lo que el "SignExt" no tiene sentido
2026-09-28 docs(formatos): agregado de diagramas de formatos
2026-09-28 docs(isa): referencia a los formatos de la instruccion desde el isa
2026-09-29 doc(isa): diagrama de formato actualizado con inst halt
2026-09-29 docs(debug unit): diagramas de flujo y de estado de la debug unit y sus comandos
2026-09-29 docs(debug unit): protocolo de la debug unit
2026-09-30 docs(halt): decision aceptada sobre la codificacion y el comportamiento de la instruccion halt
2026-09-30 docs(debug unit): correccion del comentario sobre el baud rate en el tp2
2026-09-30 docs(debug unit): correccion de referencia a archivo inexistente
2026-09-30 docs(debug unit): decisiones respectivas al protocolo de la debug unit
2026-09-30 docs(pipeline): especificación completa con registros de segmentación y señales
2026-09-30 docs(pipeline): decision-007 y diagrama del camino de datos
2026-10-02 docs(planificacion): cronograma por etapas actualizado con el avance al 02/10
2026-10-02 docs(interfaz): decision-008 TUI con Textual para la interfaz de PC
2026-10-02 docs(interfaz): boceto de pantalla, controles y modo paso a paso
2026-10-02 docs(interfaz): requisitos de terminal y puerto serie en Windows y Linux
2026-10-02 docs(decisiones): convenciones de codigo RTL
2026-10-02 rtl(common): plantilla de modulo con cabecera obligatoria
2026-10-02 tb(unit): plantilla de testbench autoverificante
2026-10-02 chore(scripts): excluir plantillas _*.v del proyecto de Vivado
2026-10-02 docs(pipeline): HALT con stop_fetch en todas las etapas y flush de IF/ID; decisiones 007 y 009 (#7)
2026-10-02 decisiones(convencion): correccion de indice
2026-10-02 docs(riesgos): diagrama de control, forwarding y deteccion de riesgos
2026-10-02 docs(riesgos): diagramas temporales de forwarding, carga-uso y salto toamdo
2026-10-02 docs(riesgos): decision-011 deteccion de load-use conservadora
2026-10-02 docs(pipeline): seccion de riesgos con forwarding, stall, flush y riesgos estructurales
2026-10-02 docs(riesgos): corregir numeracion y enlaces de la decision 011
2026-10-02 docs(saltos): decision-012 resolucion de saltos en EX sin prediccion
2026-10-02 docs(saltos): diagramas de control y salto tomado con la decision 0122 y el camino critico candidato
2026-10-02 docs(pipeline): penalizacion de saltos e hipotesis de camino critico
2026-10-02 docs(memoria): decision-013 tamaño y mapa de direcciones de las memorias
2026-10-02 docs(memoria): decision-014 BRAM true dual port y escritura de la memoria de programa por el puerto B
2026-10-02 docs(memoria): decision-015 acacesos desalineados y fuera de rango con avisos persistentes
2026-10-02 docs(memoria): especificacion de memorias con mapa, configuracion de BRAM y carga por UART
2026-10-02 docs(pipeline): PC de reset, tamaños de memoria y politica de accesos desalineados y fuera de rango
2026-10-02 docs(debug unit): avisos de acceso en flags, tamaños en INFO y validacion de READ_DMEM
2026-10-03 docs: plan de verificación
2026-10-03 docs(ensamblador): decision-017 ensamblador propio, formatos de salida y validacion
2026-10-03 tools(ensamblador): validacion contra LLVM con programas de referencia
2026-10-03 docs(decisiones): regla para pasar una decision de propuesta a aceptada
2026-10-03 docs(decisiones): estados de 001 a 017 y de spec revisados segun la regla
    - 001 a 017 pasan a aceptada (minuscula); 006 tenia el valor roto 'A'
    - 011: el titulo decia 010
    - 001, 005 y 007: puntos que dejaban abiertos ya los cierran la 004 y memoria.md
    - 009: la alternativa del reset de salida de la BRAM queda como punto abierto
    - memoria, protocolo_debug e interfaz_pc: aceptada, con sus puntos abiertos
2026-10-03 docs(spec): tildar checklists de revision de memoria, protocolo_debug e interfaz_pc
    Queda sin tildar en protocolo_debug el contenido provisorio de los latches,
    que es el punto abierto del encabezado (se cierra con pipeline.md en I-06).
2026-10-03 docs(decisiones): decision-018 programas de prueba, estado inicial y variantes con nop
2026-10-03 sw(programas): programas de prueba con su estado esperado
    - 22 programas del plan de verificacion (verificacion.md 4.1 y 4.2)
    - indep_*: instrucciones independientes desde el estado inicial, para IF a MEM sin WB
    - *_nops: variantes de los programas de riesgos y de saltos para M7
    - estado_inicial/: registros y dmem en formato $readmemh
    - .gitignore: la salida del ensamblador en sw/ no se versiona
2026-10-03 docs(spec): verificacion usa .s y agrega los programas de etapas intermedias
2026-10-03 docs(decisiones): ejecución paso a paso sin intervenir el clock (#26)
2026-10-04 docs(planificacion): reprogramación al 03/10 con el avance de M1 y M2
2026-10-05 typo en decision 18, ahora decision 19 es programas-de-prueba
2026-10-05 correccion en archivo de decision 019
2026-10-05 docs(verificacion): actualizacion de algunas secciones
2026-10-05 tools(isasim): modelo de referencia con capa ISA, pipeline ciclo a ciclo y tests (#28)
2026-10-05 Mark assembler task as completed in README
2026-10-07 tools: script que prepara un programa para el banco incremental
2026-10-07 tb: banco de pruebas incremental del pipeline y core falso
2026-10-08 tb: cargar el banco de registros al soltar el reset y renombrar cpu_en a enable
    [_riscv_core_stub.v, pipeline_tb.v]
2026-10-08 tb: comprobar el banco de registros en el ciclo 2 y resetear el banco del stub
    [_riscv_core_stub.v, pipeline_tb.v]
2026-10-08 rtl: imem con el IP imem_bram (TDP 1024x32, relleno con HALT)
2026-10-08 tb: imem_tb con contenido inicial, carga por el puerto B, latencia, ena y alias
2026-10-08 docs: decisión 022 (imem sin reset de salida, carga por el puerto B) y memoria.md §3.2 y §3.6
2026-10-11 rtl: registro IF/ID if_id_reg (valid, pc y bus de 65 bits para la Debug Unit)
2026-10-11 rtl: riscv_core con la etapa IF e interfaz de debug (enable, halted, imem_b, o_if_id_latch)
2026-10-11 tb: modo +PAUSAS en pipeline_tb para verificar que los latches respetan enable
2026-10-11 docs: decision 023 (bus por latch e if_stage) y specs de verificacion y protocolo
2026-10-14 rtl: banco de registros regfile (bypass WB->ID, enable, reset y puerto de debug)
2026-10-14 docs: pipeline.md con el puerto de debug sin bypass, el reset y la interfaz de regfile
2026-10-14 docs: imm_sel sin formato da 0 y oraculo de imm_gen_tb (rvasm + codificador propio)
2026-10-14 tb: imm_gen_tb con vectores rvasm, maximos de B y J, signo por instr[31] y aleatorio
2026-10-14 rtl: control_unit con la tabla de verdad de pipeline.md §4.4 y códigos IMM_* de imm_sel (#36)
2026-10-16 rtl: id_ex_reg con los 161 bits de pipeline.md §8, burbuja con control en 0 y bus para la Debug Unit (#38)
2026-10-17 rtl: riscv_core hasta ID con puerto de lectura del banco y o_id_ex_latch para la Debug Unit
2026-10-17 tb: id_stage_tb con la tabla de verdad, bypass de WB, enables, flush, puerto de debug y aleatorio
2026-10-17 tb: pipeline_tb con STAGE_ID, STAGES_CLI para correr niveles anteriores y lectura por el puerto de debug
2026-10-17 docs: modulo id_stage (pipeline.md §4.7) y STAGE_ID, STAGES_CLI e id_stage_tb en verificacion.md
2026-10-21 docs: decisión 025 (filtro de palabras fuera de isa.md en el toolchain), pipeline.md e interfaz_pc.md
2026-10-21 tools: classify en rvasm con las clases SUPPORTED, UNRECOGNIZED y UNSPECIFIED de pipeline.md
2026-10-21 tools: .word solo acepta palabras de isa.md y el error dice qué haría el hardware
2026-10-21 sw: test_programas usa classify en lugar de su decodificador propio
2026-10-21 tools: test_isa compara decode de isasim con classify en todo opcode × funct3 × funct7
2026-10-21 rtl: branch_unit con redirect y redirect_pc de pipeline.md §5.3 (#41)
2026-10-21 fix: TP1 y TP2 con su propia copia de la ALU
2026-10-21 tb: alu_tb para la ALU RV32I
2026-10-21 rtl: ALU RV32I con las 10 operaciones de pipeline.md y zero
2026-10-21 docs: decisión 026 y specs de la ALU
2026-10-22 tb: branch_unit_tb sin jalr con funct3 distinto de 000 (decisión 025)
2026-10-22 rtl: ex_mem_reg con los 109 bits de pipeline.md, burbuja con control en 0 y bus para la Debug Unit
2026-10-22 rtl: dmem con el IP dmem_bram, máscara de bytes y avisos de acceso
2026-10-22 docs: decisión 027 y specs de la memoria de datos
2026-10-22 docs: módulo ex_stage (pipeline.md §5.6) y casos de ex_stage_tb
2026-10-22 tb: ex_stage_tb con forwarding, saltos, enable, flush y aleatorio contra un modelo de §5
2026-10-22 tb: STAGE_EX en pipeline_tb
2026-10-23 rtl: mem_wb_reg con los 110 bits de pipeline.md, read_data de la BRAM y bus para la Debug Unit
2026-10-24 docs: módulo mem_stage (pipeline.md §6.7), comparación de dmem con STAGE_MEM y fila duplicada de dmem
2026-10-24 rtl: mem_stage con dmem y mem_wb_reg, en_mem_wb también como ena de la BRAM
2026-10-24 tb: mem_stage_tb con store y load a la misma dirección, enable, flush, avisos y aleatorio
2026-10-24 rtl: riscv_core hasta MEM con el puerto B de dmem y o_mem_wb_latch
2026-10-24 sw: indep_store_load, store seguido de load a la misma dirección
2026-10-24 tb: STAGE_MEM en pipeline_tb, dmem contra el .exp al terminar la traza y stub al día
2026-10-26 docs: módulo wb_stage (pipeline.md §7.4), avisos hacia la Debug Unit y pipeline_vacio recién con STAGE_HALT
2026-10-26 rtl: wb_stage con la extensión del load, el mux de write-back, halted e imem_fault
2026-10-26 tb: STAGE_WB en pipeline_tb, pipeline_vacio solo con STAGE_HALT
2026-10-28 docs: parada por HALT en el RTL (pipeline.md §3.4), programa sin HALT y STAGE_HALT en verificacion.md §8
2026-10-28 tb: STAGE_HALT en pipeline_tb, PC y pipeline vacío después de halted, halted y avisos en las pausas
2026-10-29 docs: saltos hacia IF desde I-36, sin flush hasta I-42, y +FINAL con STAGE_REDIRECT
2026-10-29 rtl: riscv_core con el redirect de EX hacia IF y flush_redirect en 0 hasta I-42
2026-10-29 tb: STAGE_REDIRECT en pipeline_tb
2026-11-01 tools: regresion.py y regresion.tcl para correr pipeline_tb por lotes, y ondas.tcl para la captura
2026-11-01 docs: captura de ondas de load_sin_dep_nops (I-38)
2026-11-03 tb: forwarding_unit_tb con casos dirigidos y barrido exhaustivo; ex_stage_tb sin $random dentro de ||
2026-11-03 docs: interfaz de forwarding_unit (pipeline.md §10.2) y modo del modelo en M8 (decisión 029)
2026-11-04 docs: el forwarding puede fallar (verificacion.md §6 y §8.2) y salto_depende queda para I-43 (I-40)
2026-11-04 sw: fwd_x0 prueba que una instrucción que no escribe no se reenvía (I-40)
2026-11-04 tools: salto_depende sin +FINAL en la regresión forwarding y mutantes del RTL (scripts/mutantes.py, regresion --mutante); sw: lista SOLO_TRAZA_FORWARDING (I-40)
2026-11-04 docs: forwarding hacia saltos, mutantes y resultados de la I-40 (verificacion.md §4, §6 y §8; decisiones 030 y 031)
2026-11-05 tools: los mutantes se deciden contra una pasada sin mutante y un error de Vivado no cuenta como detección (regresion.tcl, I-40)
2026-11-05 rtl: hazard_unit (I-41) y su integración en riscv_core
    Detector de carga-uso de pipeline.md §10.3: compara el rd del load en EX con los campos rs1/rs2 de la instrucción en ID, sin decodificar (decisión 011). riscv_core calcula stall = load_use & ~redirect, que retiene PC e IF/ID y mete una burbuja en ID/EX. Los enables y el flush siguen en riscv_core hasta I-42 (decisión 023).
2026-11-05 tb: hazard_unit_tb con casos dirigidos y barrido exhaustivo
    Palabras reales de rvasm (uso en rs1, rs2 y los dos; sw y beq que usan el dato; falsos positivos de HALT, lui, jal y addi) y las 131072 combinaciones de entradas contra un oráculo propio (verificacion.md §3.2).
2026-11-05 tools: modo forwarding_stall en isasim, prep_tb y regresion (por defecto); sw: listas SOLO_STALL, FORWARDING_STALL y SOLO_TRAZA_FORWARDING_STALL (I-41)
    Decisión 029: la I-41 agrega su modo, Mode(True, True, False). Suma loaduse_rs1_rs2 y halt_stall con +FINAL, y loaduse_sw_beq sin +FINAL (decisión 030): su beq se toma y el .exp difiere solo en x20, del camino equivocado, hasta I-42.
2026-11-05 docs: interfaz de hazard_unit (pipeline.md §10.3) y resultados de la I-41 (verificacion.md §4.3 y §8)
2026-11-08 rtl: hazard_unit calcula el stall, los enables y el flush por saltos (I-42); riscv_core los conecta
2026-11-08 tb: hazard_unit_tb con la tabla de enables y flush y barrido exhaustivo
2026-11-08 docs: enables y flush en hazard_unit (pipeline.md §10.4) y resultados de la I-42 (verificacion.md §4.3 y §8)
2026-11-10 tb: hazard_unit_tb no acepta X ni Z en en ni en flush (review de la #114)
2026-11-10 tools: COMPLETO = PROGRAMS y los modos anteriores a I-42 sirven con su commit (review de la #114)
2026-11-10 rtl: riscv_core documenta que load_use queda para las formas de onda (review de la #114)
2026-11-10 docs: modos por integración, hitos de §4.3 y ejemplo de corridas.txt (review de la #114)
2026-11-10 tools: mutantes del bypass del banco, el stall, el flush y la parada por HALT, y los equivalentes aparte (I-43)
2026-11-10 tools: regresión con los testbenches unitarios (decisión 032), los mutantes equivalentes por nombre y la pasada de referencia de los mutantes de verificacion.md §8.7
    regresion.tcl no tenía la pasada sin mutante que describe §8.7 ni el estado ERROR:
    un mutante que no compilaba contaba como detectado.
2026-11-10 sw: loaduse_sw_beq con un load seguido de jalr que salta a la dirección cargada (I-43)
2026-11-10 tools: ciclos por programa (scripts/ciclos.py) y test de la fórmula de ciclos en isasim (I-43)
2026-11-10 tools: uart_tb fuera de la regresión del procesador: su DUT es el top del TP2 (decisión 032)
2026-11-10 tools: regresion.py escribe la lista de los mutantes equivalentes y borra las listas de regresion.tcl antes de empezar, así un error no deja las de la corrida anterior
2026-11-10 tb: pipeline_tb corre varias corridas en una simulación con +LISTA (decisión 033)
    Cada línea de la lista es una corrida: etiqueta, directorio, final, pausas y semilla. La secuencia pasa a la tarea correr, que empieza con el core en reset y pone en cero errores, chequeos y ciclos; el watchdog va en vigilada. Un timeout o un archivo que falta terminan la corrida, no la simulación. Antes de cada corrida imprime CORRIDA <etiqueta> y al final LISTA: n de m. Con +DIR no cambia nada.
2026-11-10 tools: regresion.tcl corre cada pasada en una sola simulación de pipeline_tb (decisión 033)
    Escribe build/regresion/lista_tb.txt desde corridas.txt, corre pipeline_tb con +LISTA y parte el log en las líneas CORRIDA. Cada parte va a logs/[<mutante>/]<etiqueta>.log y se decide por su última línea TEST, como antes; el log entero queda en pipeline_tb.log. Una corrida que no aparece en el log, o cuya parte no tiene línea TEST, queda en ERROR. Si la ruta del repositorio tiene espacios, avisa antes de empezar.
2026-11-10 docs: decisión 033 y mutantes de la I-43 (verificacion.md §8.1, §8.2 y §8.7)
    Decisión 033: varias corridas en una simulación de pipeline_tb. §8.1: plusarg LISTA y watchdog por corrida. §8.7: cómo corre regresion.tcl y los tiempos. §8.2: tabla de los 39 mutantes en --modo completo, el estado que el reset no borra (bypass_sin_we y stall_sin_mem_read) y los dos equivalentes, NO DETECTADO.
2026-11-10 tools: regresion.py --invertir escribe las corridas en orden inverso (decisión 033)
    Con +LISTA el orden decide qué corrida va primero y cuál deja su estado a la siguiente. Con un mutante que ve el estado que el reset no borra (bypass_sin_we, stall_sin_mem_read), correr en los dos órdenes separa las fallas propias del programa de las que dependen de la corrida anterior (verificacion.md §8.2).
2026-11-10 docs: criterio para los mutantes que ven el estado que el reset no borra (verificacion.md §8.2 y §8.7, decisión 033)
    Un programa cuenta como detector si falla en los dos órdenes (regresion.py --invertir); así la tabla cuenta 3 para bypass_sin_we y no las 5 del resumen. Corrige la ventana: estas fallas aparecen en la traza hasta el ciclo 5, no hasta el 4, y el ciclo solo no alcanza para separarlas.
2026-11-10 tools: rvdebug, cliente del protocolo de la Debug Unit con tramas, timeouts, reintentos y EVT_HALTED (I-50)
    protocol.py arma y valida las tramas y parte los bloques de protocolo_debug.md §2 y §3.
    client.py tiene un método por comando, reintenta según §5 sin repetir STEP ni RUN a
    ciegas, y antes de LOAD rechaza con classify toda palabra fuera de isa.md (decisión 025).
2026-11-10 tools: Debug Unit simulada y tests del cliente sin FPGA (I-50)
    Puerto simulado con fallos inyectables y reloj falso. Prueba las tramas de ejemplo de §4,
    el READ_ALL del modelo de referencia, cada comando, los reintentos, el EVT_HALTED, el
    watchdog y STOP desde otro hilo.
2026-11-10 tools: rvasm.disassemble envuelve el desensamblado de isasim, con classify antes de decodificar (I-51, decisión 034)
    Una palabra de isa.md la decodifica y la pasa a texto el modelo (tablas propias, independientes de rvasm/isa.py); una fuera de isa.md sale como .word con el motivo de classify y qué haría el hardware, en vez del ModelError de decode. 0x00000013 sale como nop. Un branch o jal con desplazamiento no múltiplo de 4 (como el .word 0xdeadbeef de isa_completo.s) sale como .word con la instrucción en el comentario, porque rvasm no acepta ese desplazamiento en la fuente. isasim se importa recién al desensamblar: import rvasm no carga el modelo.
2026-11-10 tools: tests del desensamblador con ida y vuelta sobre sw/, tests/programs/ y palabras al azar (I-51)
    El texto esperado de cada instrucción de isa.md, escrito a mano, con inmediatos en los extremos y saltos hacia atrás y hacia adelante hasta los límites de B y J. Ensamblar, desensamblar y volver a ensamblar da las mismas palabras en los programas de sw/ y de tests/programs/ y en 10 000 palabras de isa.md armadas al azar desde sus campos, con semilla fija. También los saltos con desplazamiento no múltiplo de 4, las palabras fuera de isa.md (el ensamblador rechaza su .word) y que import rvasm no carga isasim.
2026-11-10 docs: decisión 034 y desensamblador en los README (rvasm §8, isasim e interfaz_pc.md §7)
    Decisión 034: rvasm envuelve el desensamblado del modelo en lugar de escribir un tercer decodificador o ponerlo en rvdebug. README del ensamblador: §8 nueva con el formato del texto (Estructura pasa a §9), ejemplo en §1 y test_disasm.py en §6. README de isasim: cambiar el texto de disassemble cambia lo que muestra la interfaz. interfaz_pc.md §7: la API de desensamblado.
2026-11-11 docs: T_RESP cuenta los bytes de la petición y orden del EVT_HALTED en §3.5 (review de la #116)
    Con solo la respuesta, el plazo de un LOAD es de 0,2 s y 1024 palabras tardan 0,36 s en
    salir. §3.5 deja escrito que la confirmación de RUN sale antes que su EVT_HALTED, y que una
    respuesta que dice RUNNING sale antes que el evento de esa ejecución.
2026-11-11 tools: last_status se borra con NoResponseError y en connect, y test de T_RESP con un LOAD grande (review de la #116)
    Después de un LOAD que la FPGA hizo pero sin respuesta, step() comparaba con un cycles
    viejo y, si se perdía la respuesta del STEP, lo repetía. El README remite a §5 para T_RESP.
2026-11-12 rtl: uart de la Debug Unit con FIFO de recepción, y baud_gen.v con el nombre de su módulo (I-44, decisión 035)
2026-11-12 tb: uart_tb prueba la UART de la Debug Unit, uart_fifo_tb la FIFO, y el del sistema del TP2 pasa a tp2_uart_top_tb (I-44)
2026-11-12 tools: uart_tb y uart_fifo_tb entran a la regresión y tp2_uart_top_tb queda en OTRO_DISENO (I-44, decisión 035)
2026-11-12 docs: decisión 035 y la UART de la Debug Unit en protocolo_debug.md §1, verificacion.md §3.3 y §8.7, memoria.md y README (I-44)
2026-11-12 rtl: debug_unit con la FSM de protocolo de la Debug Unit y los códigos del protocolo en riscv_defs.vh (I-45, decisión 036)
2026-11-12 tb: debug_cmd_fsm_tb prueba debug_unit con un modelo de PC que manda y recibe tramas por la línea serie (I-45)
2026-11-12 docs: decisión 036 y la FSM de protocolo en protocolo_debug.md §3.1, §5 y §7 y verificacion.md §3.3 y §8.7 (I-45)
2026-11-12 docs: o_pl_idx cuenta desde el primer byte del payload y en READ_ALL la fuente entrega desde el 12, en protocolo_debug.md §7, la cabecera de debug_unit y la decisión 036 (I-45)
